argonraver/quadruped-robot-for-smart-agriculture-uofu/README.md

# quadruped-robot-for-smart-agriculture-uofu
Open source quadruped robot for smart agriculture research from the University of Utah.

## Team Members
Austin Neff, Kevin Nelson, Jordan Raver, Ben Siesser, Sam Spencer, and Yang Yang

## Project Advisors
Shad Roundy and Kam Leang
