argonraver/quadruped-robot-for-smart-agriculture-uofu/Quadruped Robot for Smart Agriculture/Spring Assignments/Project Milestones Document.docx

1. Project Problem Statement & Scope

Problem statement: The objective of the project is to construct a quadruped robot. The Open Dynamic Robot Initiative will be used as guidance. The robot is intended as a cheaper and more open alternative for robot smart agriculture than what is currently available in professors Roundy and Leang’s laboratories.

The only change is that field navigation was changed from “Must be part of scope” to “Optional scope”

Must be part of scope | Optional Scope | Not included in Scope
1. Runs on ROS 2 2. Use ROS 2 Humble 3. Autonomous; no tether 4. On-board Power System that can run for minimum 30 minutes 5. Modify design to enclose electronics –weathertight 6. Easily storable, carryable (handles, box) 7. Utah red colors | 1. Can navigate to four points in a field. 2. Rebuild chassis with stronger materials during second semester (fiberglass infused ABS) | - Additional actuators - Additional sensors - Efficient walking - Manipulators - Radio beacon triangulation - 12 degree of freedom

2. ME EN 4010 Milestones & Tasks

ME EN 4010 Assignment | Milestone(s) | Metric of success | Measurement | Tasks
Design Review 1 (01/27-01/31) | 1. Foundational control code complete and to command ODrive controller boards while being able to receive information from the IMU | Command capability, sensor reading | <200 ms latency while switching modes and updating and filtering IMU readings | Write the following nodes: - Central command node - Primitive loader - Leg control and IK node - IMU node - Filter node - Node to convert primitive to ramp, offset according to IMU
| 2. Majority of robot body complete including eight control board mounting brackets, two battery mounts, and printed leg components for eight legs | Proportion of components mounted | >90% (eight control board mounting brackets, two battery mounts, OrangePi and power distribution board mounts, all components added to mounts and wired up) | - Print all body components - Assemble body - Mount electronics - Wire everything up
| 3. Two leg segments complete and mounted for initial single leg testing | Number of actuator modules built | At least 2 modules (1 leg) | - Print legs in CFPLA - Assemble actuators - Mount actuators as they are completed
Midterm Prototype & Report (02/21) | 4. All four legs mounted and actuated for coordinated movement | Number of actuator modules built | All 8 modules | - Print remaining legs - Finish assembly - Mount remaining actuators
| 5. Body complete and enclosed with a lid printed in CF-PLA | Proportion of components mounted | 100% (All components from before plus legs mounted and additional “lid” and handle finished and attached) | - Complete any remaining tasks from above - Add any necessary sensors for navigation
| 6. Basic Motion achieved, able to coordinate all leg segments to make the robot stand up, turn, walk consistently in lab environment(Not necessarily including speed variance, rough terrain) | Number of directions of motion available via primitives | 6 (Left Turn, Right Turn, Forwards, Backwards, Rise, Crouch) | Create primitives to: - Walk forward or backward - Turn left or right - Stand up - Lay down - battery test (how far can it go?)
Design Review 2 (03/17-03/21) | 7. Fully autonomous; no tether. Robot is able to run off of battery power and be controlled via a SSH network | No physical connections necessary to direct and move | Zero physical connections without loss of functionality | - Build the power system to be self sufficient - Implement wireless command system
| 8. On-board Power System can run for minimum 30 minutes | Runtime in general walking scenario | >30 minutes | - Develop an endurance test - Run the test, log results - Test additional battery sizes if results are disagreeable
| 9. Full motion of robot, able to walk distances consistently without issues in varied environments including outdoor areas | Variable speed, rough terrain capability | Variable speed: Number of alternate sets of walking primitives that enable alternate speeds. Target of at least two. Rough Terrain Capability: Test maximum grade robot can walk up (at least 30 degrees), largest offset between legs it can pass over without toppling (>4 inches), largest radius object it can step on edge of without slipping (>1 inch) | - Add IMU modification to target joint angles - Create additional primitives for faster or slower gaits
| 10. Basic Navigation to beacons using GPS or towards a radio frequency (optional scope) | Can navigate to beacons with wireless (radio) detection. Basic navigation entails a simple depth first search algorithm to move across discretized field locations until signal peaks for goal. | Navigation to at least one beacon during runtime. | - Implement necessary additional sensors - Write a simple seeker node
Final Report (04/14) | 11. Optimize Navigation to path-find to four beacons in different locations (optional scope) | Can reach target number of beacons during runtime. Optimized navigation depends on a higher level dynamic motion planning algorithm. | Can reach all four beacons and return within runtime | - Implement advanced navigation algorithm - Expand seeker node to accept multiple targets

3. Team Member Roles

Austin- I will be helping Ben with the 3D printing and assembly. Along with that I will be leading the charge on documents, assignments, and slides. I will be very involved in testing and debugging. I will also be available to help the coding team and power system in any way I can.

Ben- I will be leading 3D printing and assembly along with being lead 3D modeler. I will be very involved in testing the design structurally, especially fixing the mechanical design if it breaks or needs to be fixed. I will also help the power system team in any way I can.

Sam - I also will be working on the layout and mounting hardware for the internal components. I will also be working on the power system. This will include creating cables and solving cable management problems, as well as implementing a power distribution board which supplies the required current and various voltages.

Kevin - I am the lead on both design and implementation of our code. I will be coming up with the general arrangement of nodes to control our robot, refining them with the rest of the group, then actually implementing them. For any nodes where performance is a concern, they will need to be implemented in C++ which is my purview. I will also work to make sure that all components integrate together effectively, and that no robot components clash with each other’s functionality.

Jordan - I am the second main programmer on the team and will help design and implement our code. I’ll be helping to write and organize nodes, primitives, and control algorithms for our robot and will also be focusing on the kinematics of our robot to implement into our control algorithms. I will also be helping out with the assembly as much as I can when I’m not working on the code.

Yang - I am helping with code and building as needed. I’m looking into and helping with programming auxiliary functions, like sensors. I’m primarily responsible for keeping track of the bill of materials, budget, and submitting buy orders.

4. Final Deliverables

- Final assembled robot
- Email\flash drive with all code and 3d printed part models
- ME EN 4010 Final Report, poster presentation files
- Documentation for setup and code use
- Bill of Materials
- Videos of robot working
- Any spare or extra parts and materials

5. Concerns, Challenges, Special Needs, etc.

Our biggest challenge for the semester is to make the walking software. Making good primitives is going to take a lot of time.

6. Advisor Approval

This document must be approved by your faculty advisor and/or project sponsor. You may upload a PDF copy of an email from your advisor or sponsor saying that they have read and approved the Project Milestones document. Alternatively, you may have them sign a digital copy of the document.

Engineering Design II – ME EN 4010 Spring 2025
