argonraver/quadruped-robot-for-smart-agriculture-uofu/Quadruped Robot for Smart Agriculture/Demo.pptx

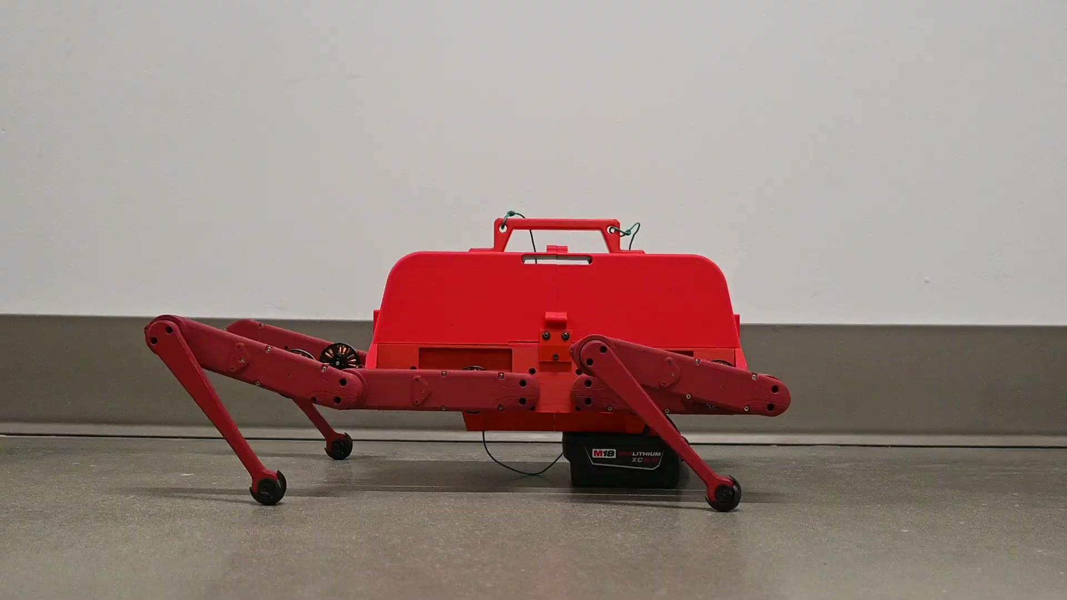
[picture p63: figure]

## Slide 2

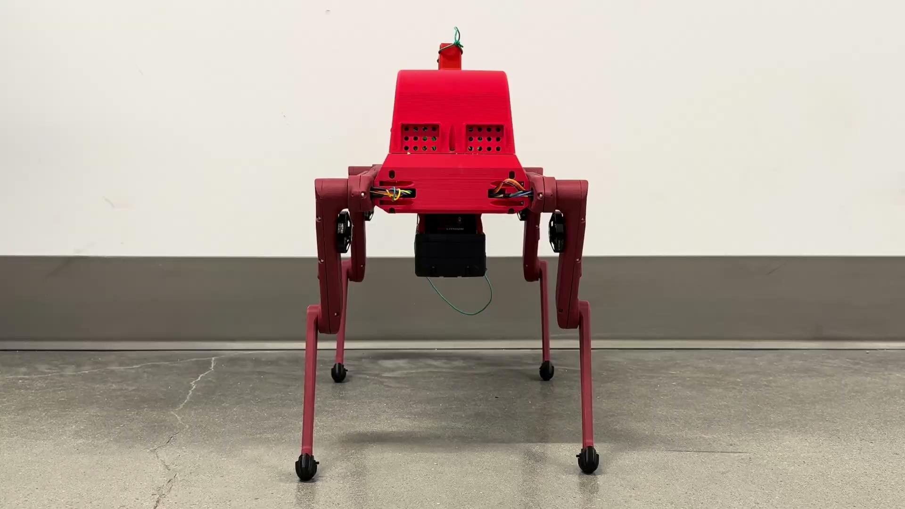
[picture p64: figure]

## Slide 3

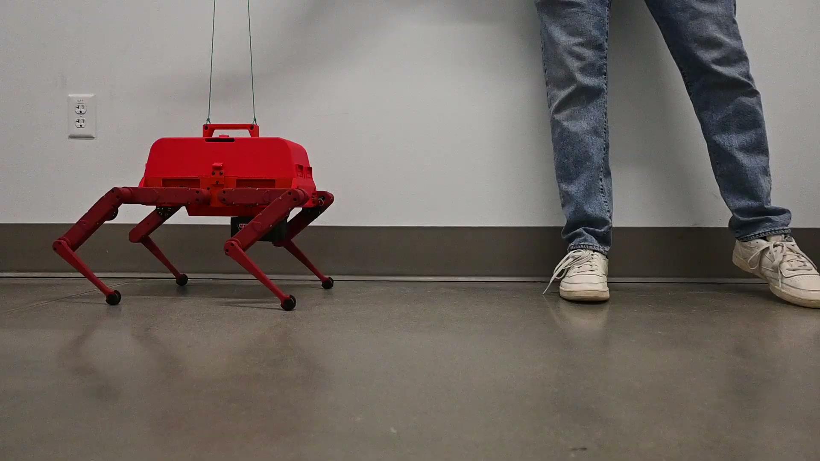
[picture p65: figure]

## Slide 4

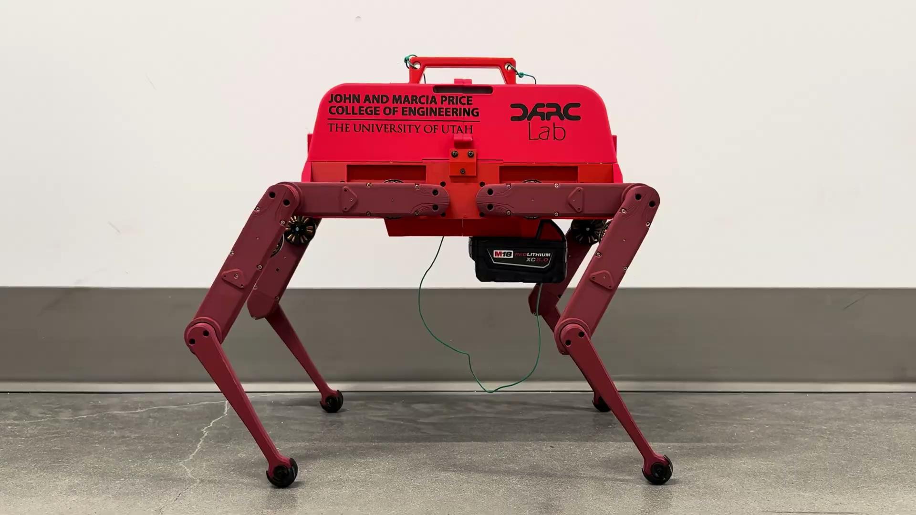
[picture p66: figure]

## Slide 5

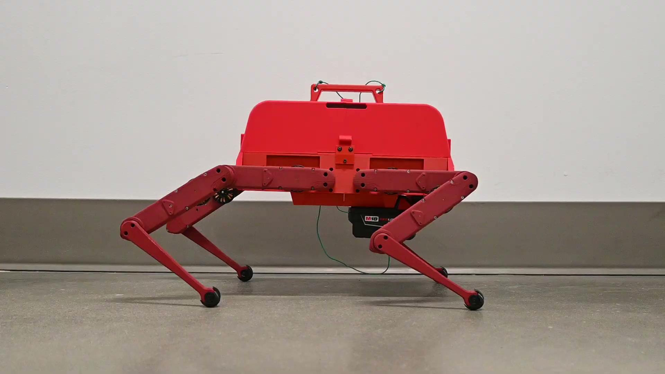
[picture p67: figure]
