argonraver/quadruped-robot-for-smart-agriculture-uofu/Pictures and Videos/DSC_0645.JPG

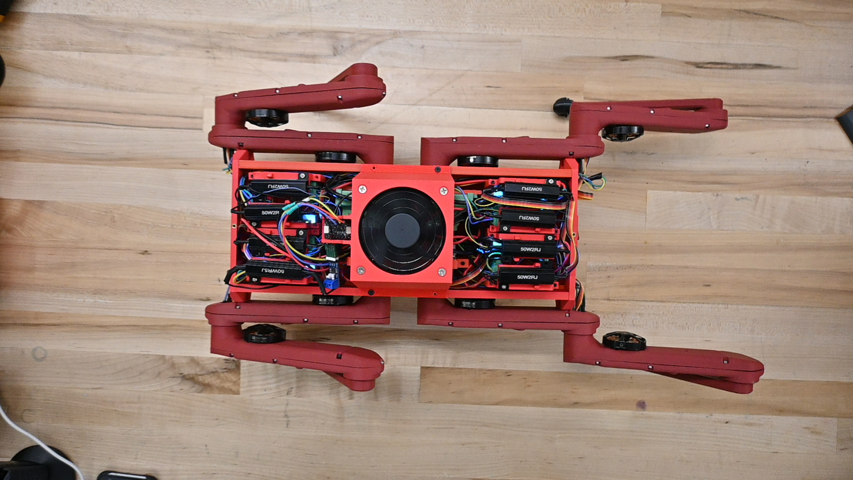
Pictures and Videos/DSC_0645.JPG
