argonraver/quadruped-robot-for-smart-agriculture-uofu/Quadruped Robot for Smart Agriculture/Documentation/ODrive Arrangement.jpg

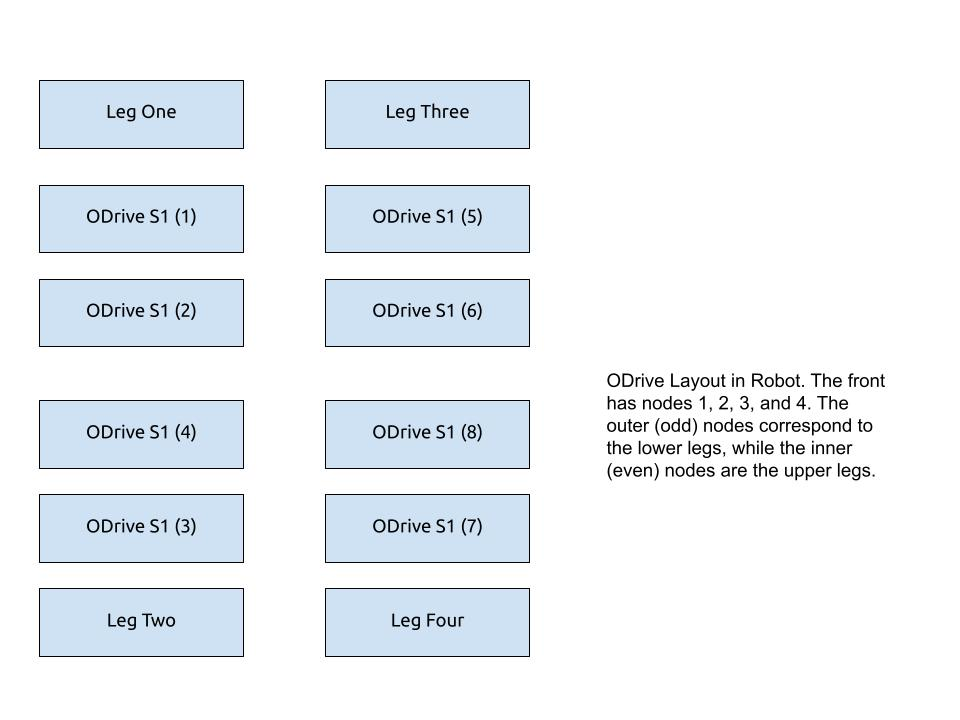
Quadruped Robot for Smart Agriculture/Documentation/ODrive Arrangement.jpg
