argonraver/quadruped-robot-for-smart-agriculture-uofu/Quadruped Robot for Smart Agriculture/Fall Assignments/Sketches/Charging Case.jpg

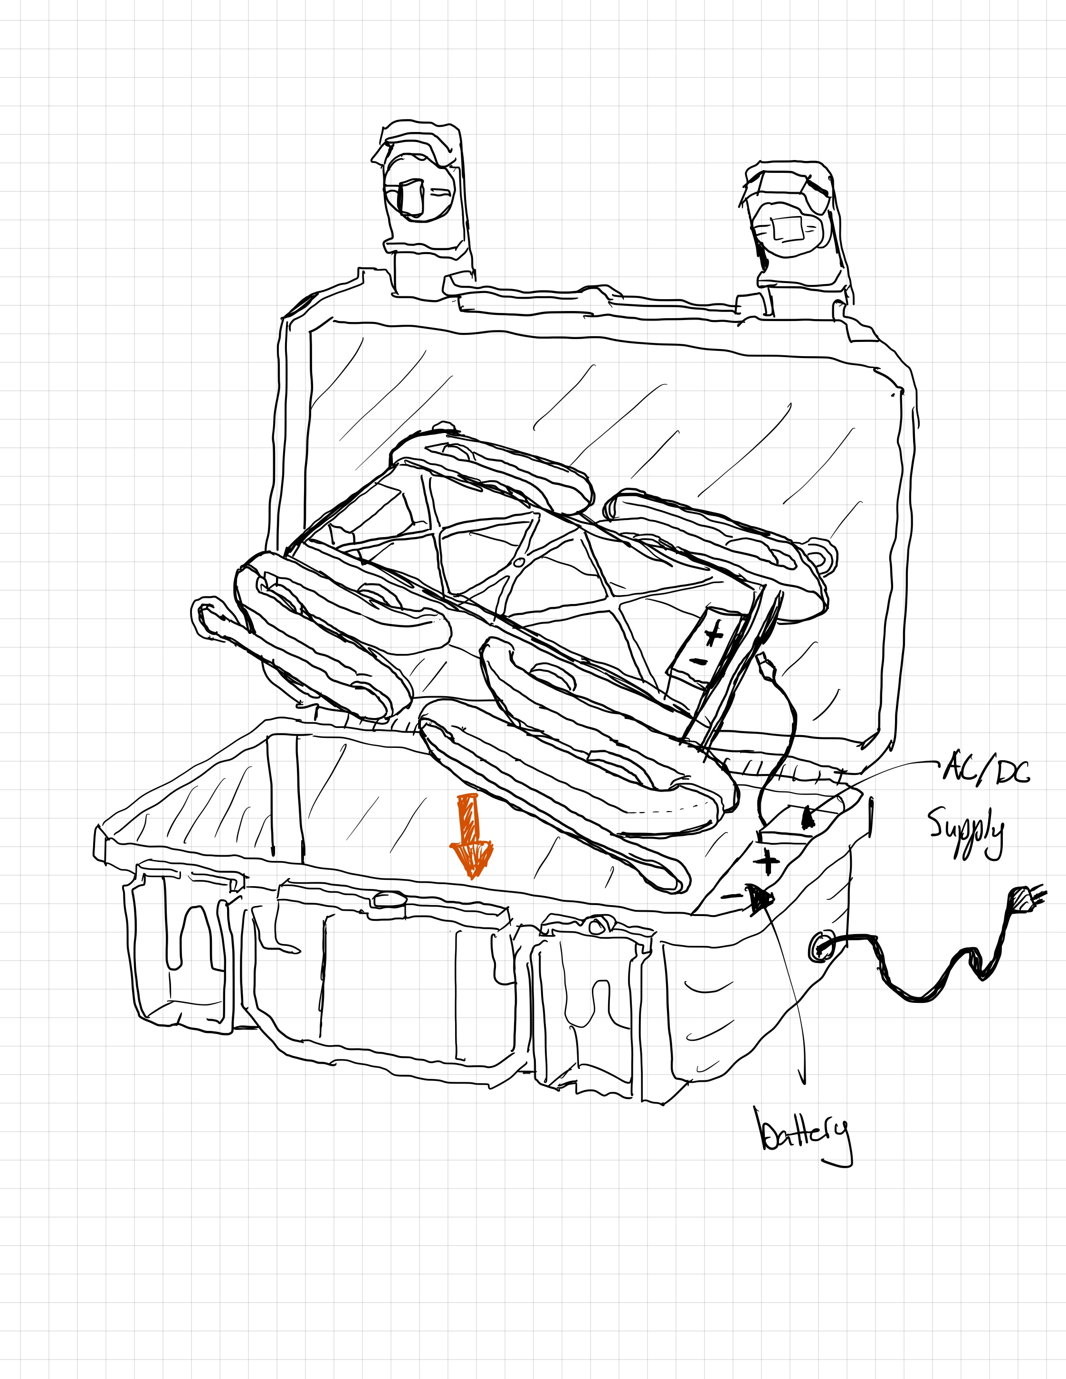
Quadruped Robot for Smart Agriculture/Fall Assignments/Sketches/Charging Case.jpg
