argonraver/quadruped-robot-for-smart-agriculture-uofu/Quadruped Robot for Smart Agriculture/Fall Assignments/Sketches/Dual Purpose Lid Case.jpg

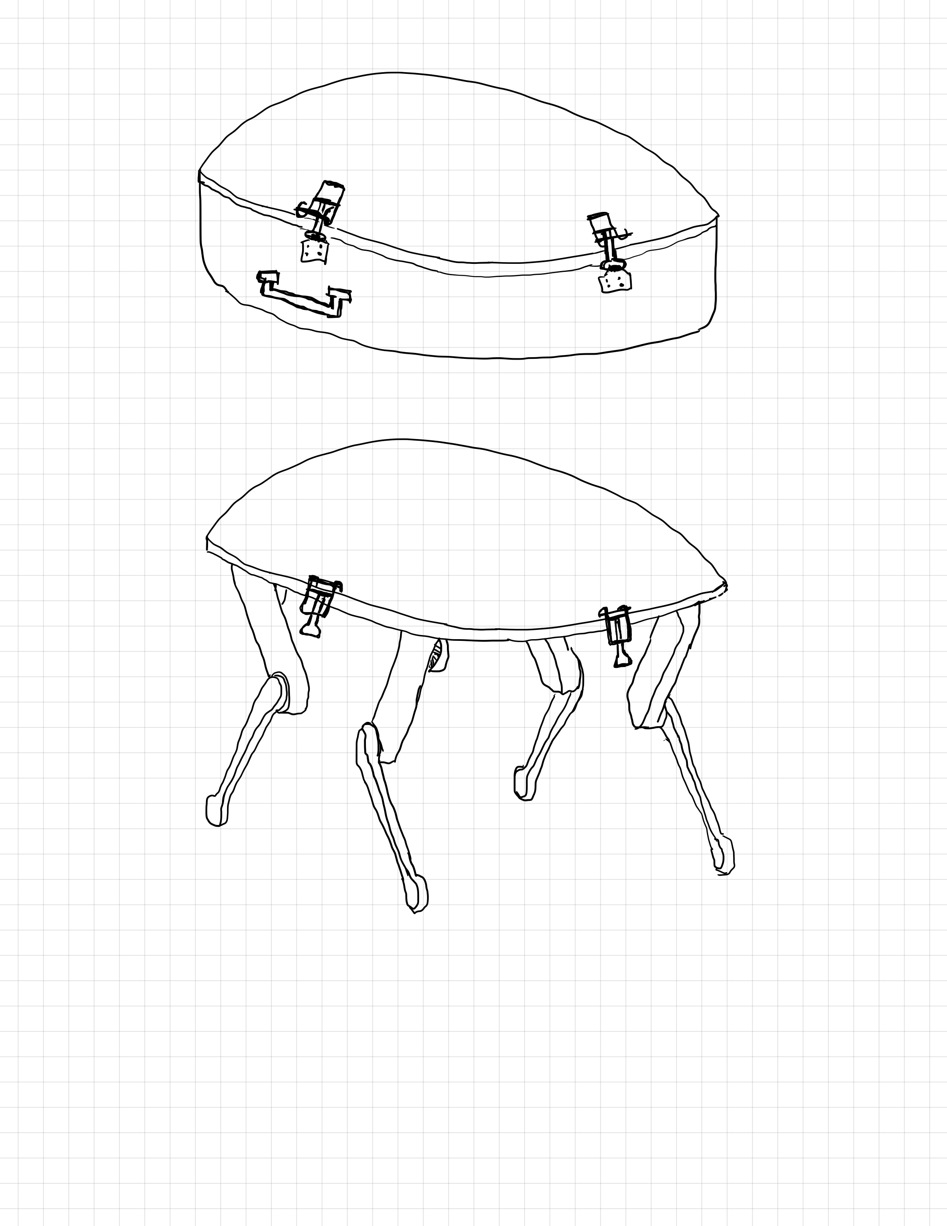
Quadruped Robot for Smart Agriculture/Fall Assignments/Sketches/Dual Purpose Lid Case.jpg
