argonraver/quadruped-robot-for-smart-agriculture-uofu/Quadruped Robot for Smart Agriculture/Fall Assignments/Sketches/Gel Coated.jpg

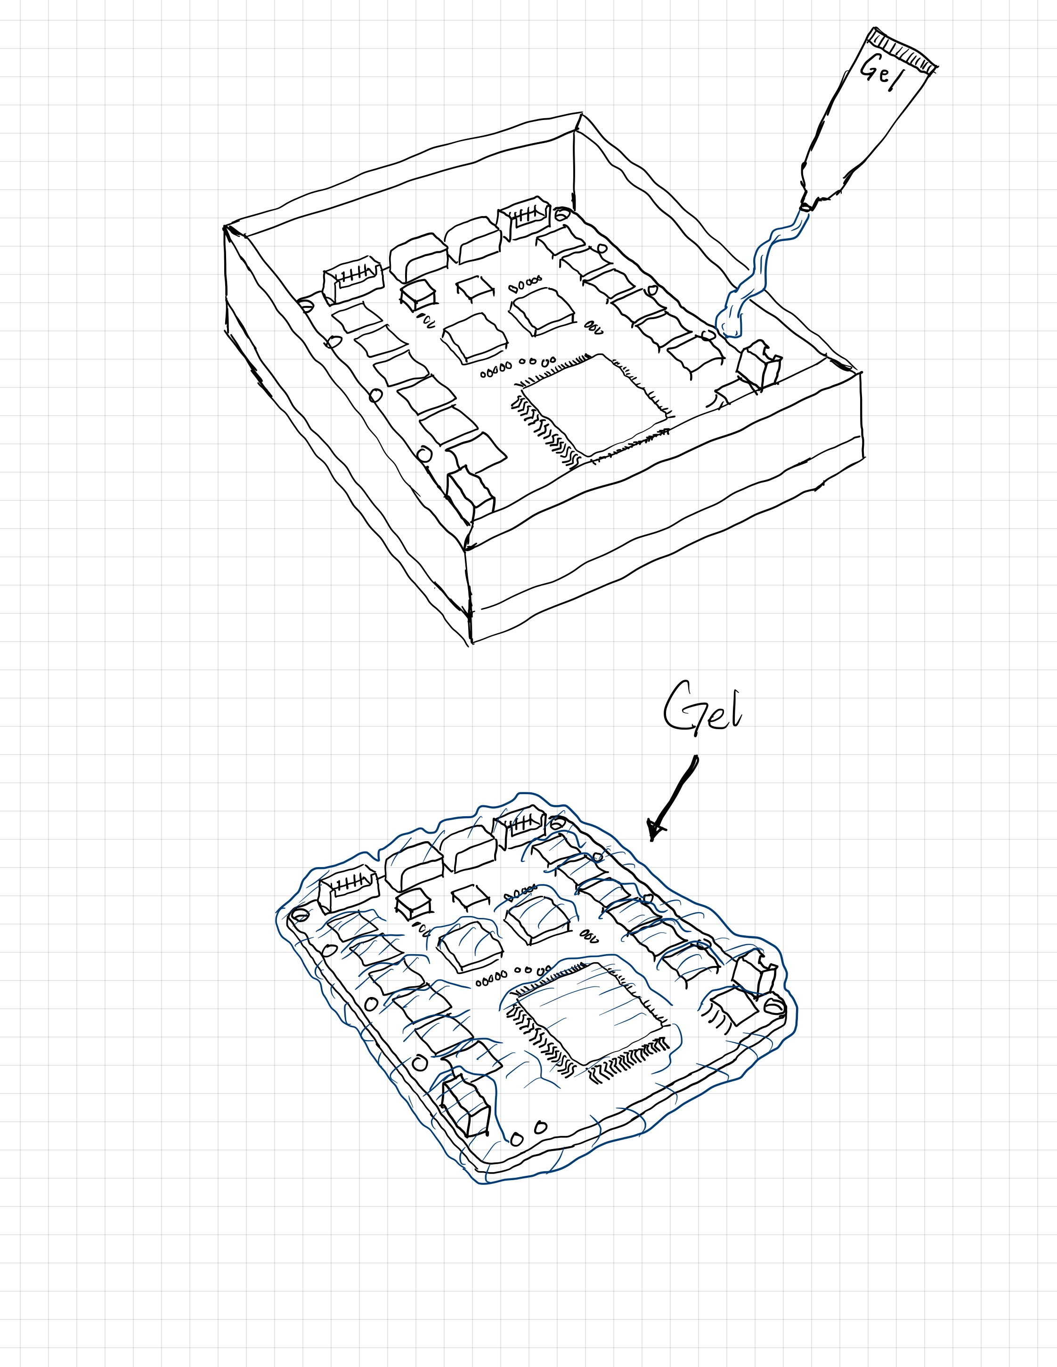
Quadruped Robot for Smart Agriculture/Fall Assignments/Sketches/Gel Coated.jpg
