argonraver/quadruped-robot-for-smart-agriculture-uofu/Quadruped Robot for Smart Agriculture/Fall Assignments/Sketches/Hard Cover.jpg

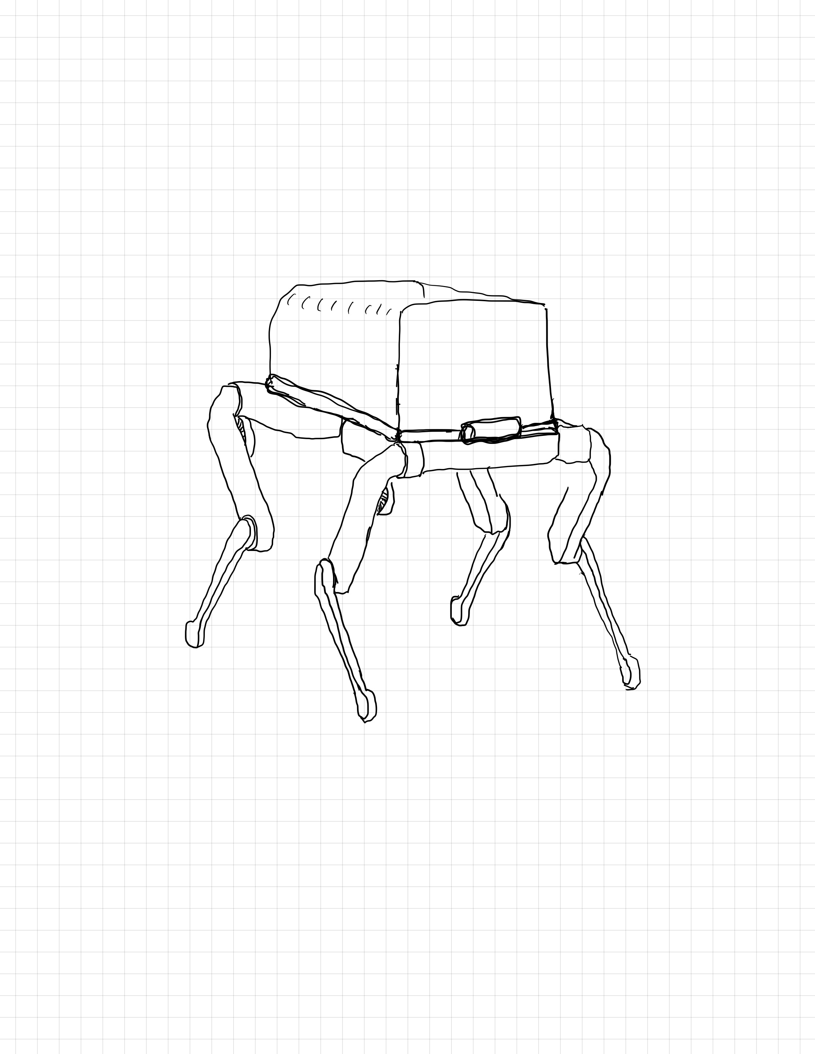
Quadruped Robot for Smart Agriculture/Fall Assignments/Sketches/Hard Cover.jpg
