argonraver/quadruped-robot-for-smart-agriculture-uofu/Quadruped Robot for Smart Agriculture/Fall Assignments/Sketches/Umbrella.jpg

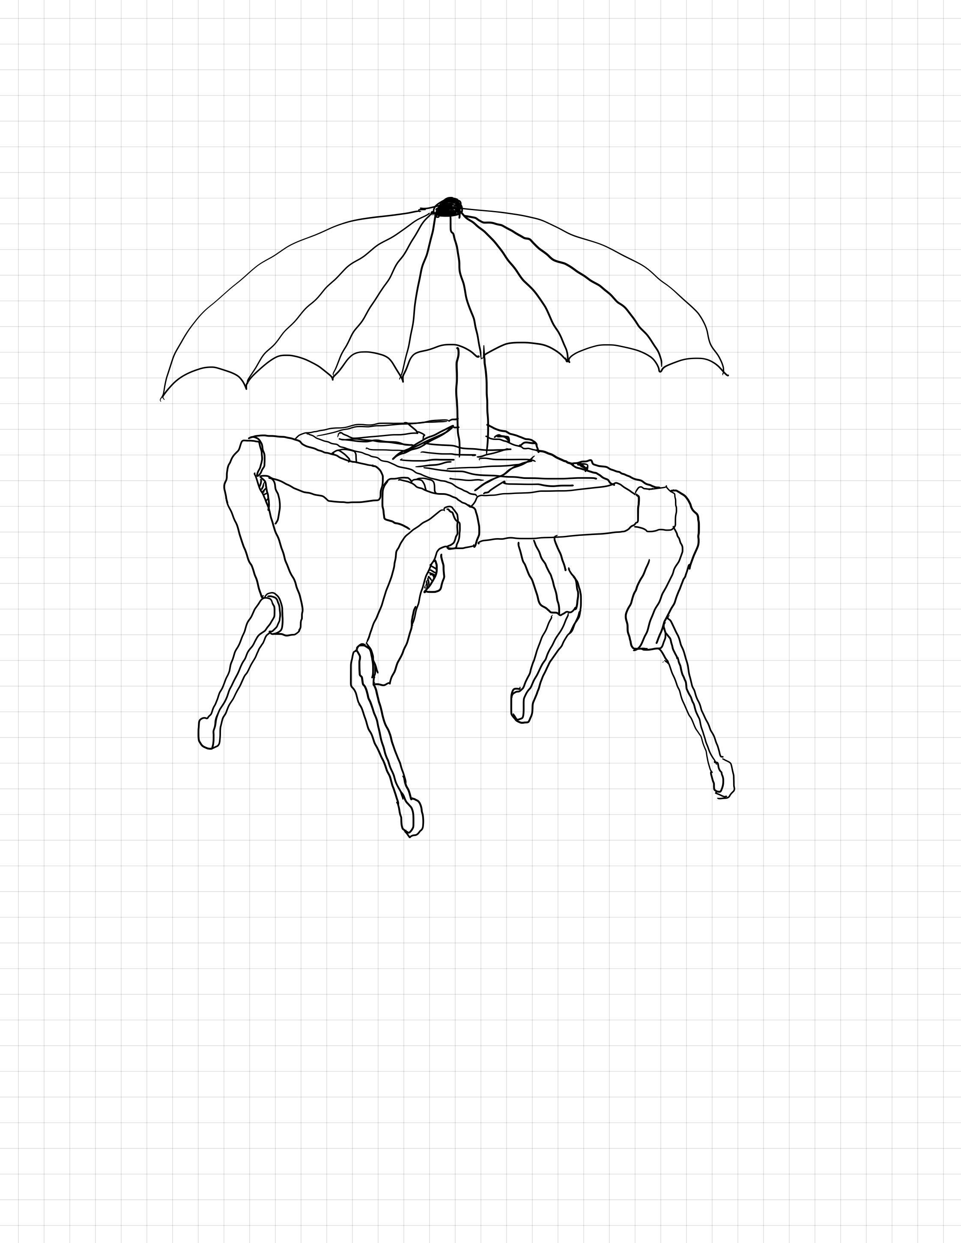
Quadruped Robot for Smart Agriculture/Fall Assignments/Sketches/Umbrella.jpg
