argonraver/quadruped-robot-for-smart-agriculture-uofu/Quadruped Robot for Smart Agriculture/Fall Assignments/Sketches/Wide Feet.jpg

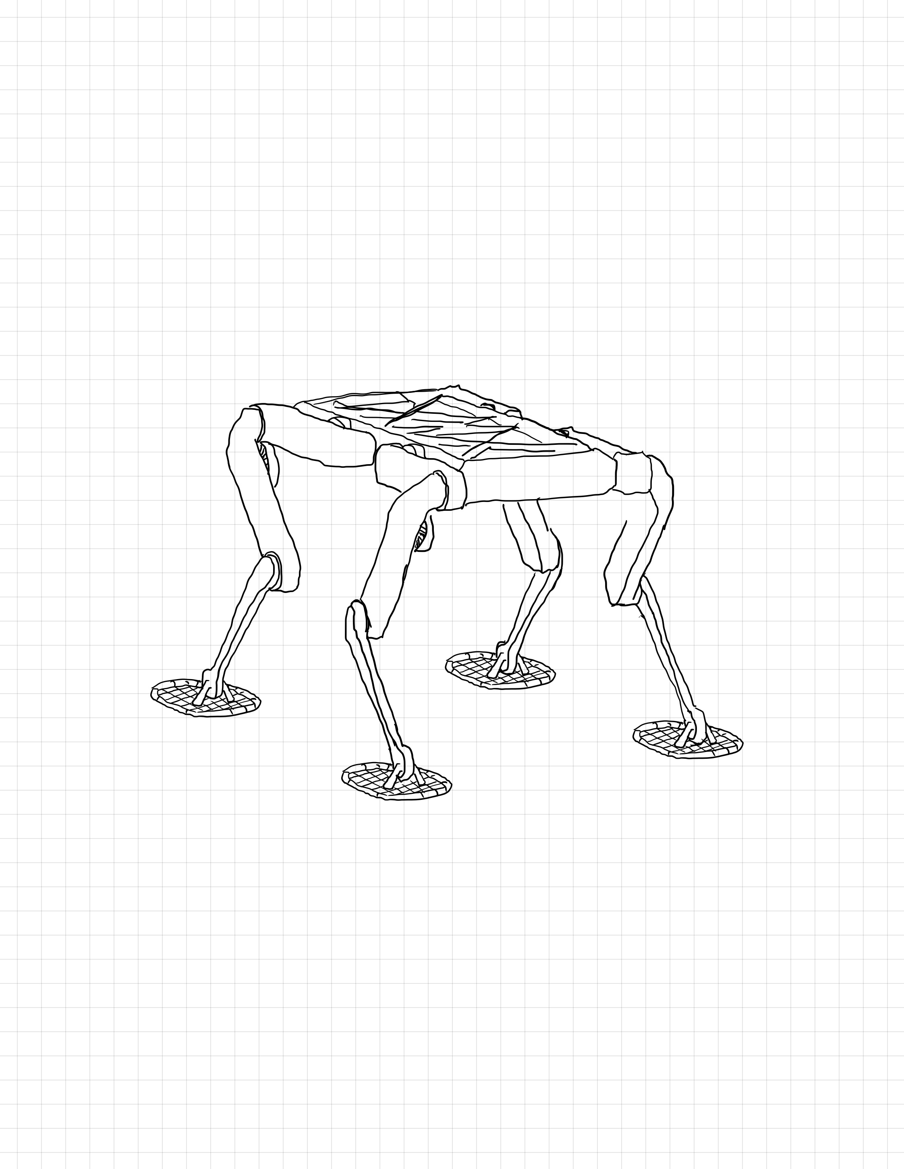
Quadruped Robot for Smart Agriculture/Fall Assignments/Sketches/Wide Feet.jpg
