argonraver/quadruped-robot-for-smart-agriculture-uofu/Quadruped Robot for Smart Agriculture/RobotElectronics Sketch_schem.png

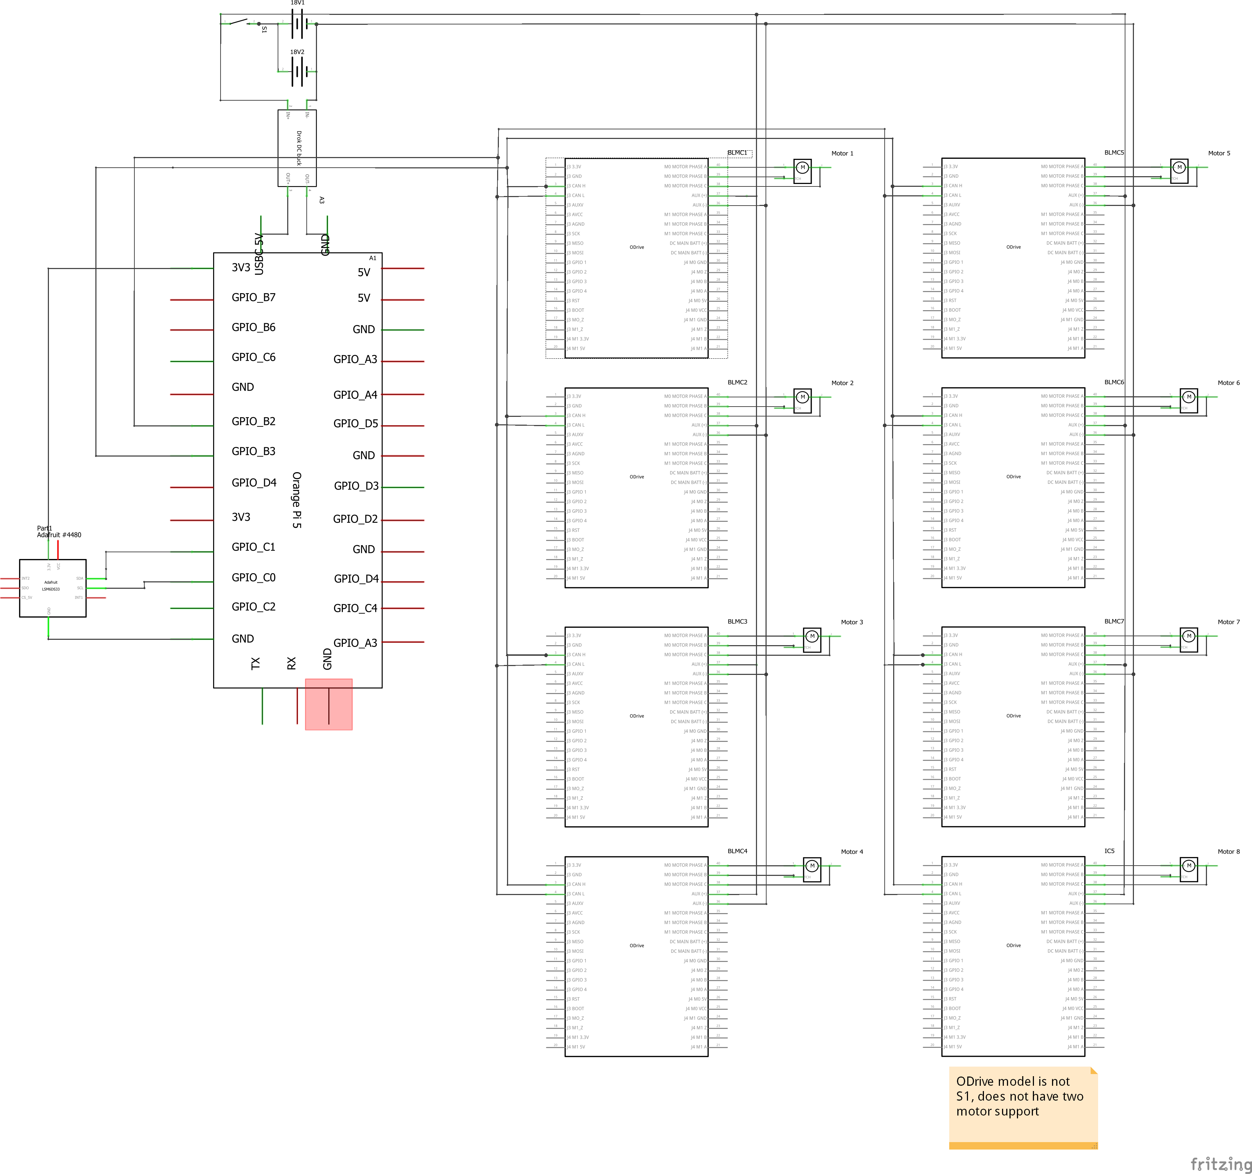
Quadruped Robot for Smart Agriculture/RobotElectronics Sketch_schem.png
