argonraver/quadruped-robot-for-smart-agriculture-uofu/Quadruped Robot for Smart Agriculture/BOM.xlsx

Sheet: Consolidated BOM
Part | Link | Supplier | Quantity | Price Individual Part | Price All Parts | Description | Off the Shelf (Y/N) | Contact Info | Order Placed | Cost Breakdowns | Total Spent
M3 x 5 SS (50 pcs) | https://www.mcmaster.com/products/screws/flat-head-screws~/flat-head-profile~standard/system-of-measurement~metric/metric-316-stainless-steel-hex-drive-flat-h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 | mcmaster | 1 | $5.09 | $5.09 | M3 x 5mm 316 Stainless | Y | N/A | x | Subtotal | $4431.90
M3 Screw and Nut Assortment | https://www.amazon.com/dp/B0B51BFSWZ?s=hi&sp_csd=d2lkZ2V0TmFtZT1zcF9kZXRhaWw | Amazon | 1 | $7.99 | $7.99 | Kadrick Small Metric Screws Suitable for 3D Printer DIY, 400 Pcs M3 Screw and Nut Assortment Hex Socket Head Cap, 12.9 Grade Alloy Steel,Black Zinc Plated | Y | N/A | x | $4180.94
M3 x 4.5 Helicoil (10 pcs) | https://www.mcmaster.com/products/threaded-inserts/threaded-inserts-2~/stainless-steel-helical-inserts-9/ | mcmaster | 3 | $8.98 | $26.94 | Stainless Steel Helical Insert, M3 x 0.5 Thread Size, 4.5 mm Long | Y | N/A | x
M3 x 6 Helicoil (10 pcs) | https://www.mcmaster.com/products/threaded-inserts/threaded-inserts-2~/stainless-steel-helical-inserts-9/ | mcmaster | 3 | $11.35 | $34.05 | Stainless Steel Helical Insert, M3 x 0.5 Thread Size, 6 mm Long | Y | N/A | x
Brushless Motor (2pk) | https://shop.tmotor.com/products/mn2806-1 | Lab | 4 | $0.00 | $0.00 | TMOTOR MN4004 300kv AntiGravity UAV Brushless Motor | Y | N/A | x
Bearing Output Shaft | https://www.123bearing.com/bearing-housing/deep-groove-bearing/single-row/61705-2rs?gad_source=1 | 123-Bearing | 16 | $5.02 | $92.42 | 32mm x 25mm x 4mm EZO bearing 61705 2RS VA | Y | N/A | x
Bearing Motor Shaft and Center Shaft | https://www.123bearing.com/bearing-housing/deep-groove-bearing/single-row/mr84-ezo?gad_source=1 | 123-Bearing | 24 | $8.03 | $166.56 | 8mm x 4mm x 2mm EZO bearing MR84 VA | Y | N/A | x
Bearing Timing Belt Tensioner | https://www.123bearing.com/bearing-housing/deep-groove-bearing/single-row/683-zz-ezo?gad_source=1 | 123-Bearing | 16 | $6.24 | $112.64 | 7mm x 3mm x 3mm EZO bearing 683 2Z VA | Y` | N/A | x
Timing belt first stage | https://www.beltingonline.com/at3-gen-iii-synchroflex-timing-belts-4593 | Belting Online | 8 | $5.96 | $47.71 | Timing Belt Conti Synchroflex AT3 GEN III width: 4mm / length: 150mm / 50 teeth | Y | N/A | x
Timing belt second stage | https://www.beltingonline.com/at3-gen-iii-synchroflex-timing-belts-4593 | Belting Online | 8 | $8.94 | $71.53 | Timing Belt Conti Synchroflex AT3 GEN III width: 6mm / length: 201mm / 67 teeth | Y | N/A | x
Encoder Kits | https://github.com/open-dynamic-robot-initiative/open_robot_actuator_hardware/blob/master/mechanics/general/details/20210407_ODRI-KIT-new.pdf | PWB | 8 | $155.72 | 1245.77 | ODRI Encoder Kit v1.0 #109381 | N | info@pwb-encoders.com | x
M3 x 16mm Plastic Screws (20 pcs) | https://www.amazon.com/uxcell-Plastic-Phillips-Machine-Washers/dp/B0B7RGWSQQ?th=1 | Amazon | 1 | $8.89 | $8.89 | M3 x 16mm Plastic Phillips Machine Screws with Nuts and Flat Washers | Y | N/A | x
20 AWG Cu Wire (6 color, 50 ft each) | https://www.amazon.com/NAOEVO-Silicone-Electrical-Breadboard-Automotive/dp/B0CML8MQD5 | Amazon | 1 | $27.99 | $27.99 | NAOEVO 20 Gauge Wire 300ft, 20 AWG Silicone Wire 50ft Each Spool, 6 Colors Flexible Tinned Copper Wire Electrical Wire | Y | N/A | x
26 AWG Cu Wire (6 color, 50 ft each) | https://www.amazon.com/dp/B089CSCY8S/ref=twister_B0DDXRJX1W?_encoding=UTF8&th=1 | Amazon | 1 | $24.49 | $24.49 | Fermerry 26 AWG Stranded Wire Spool 50ft Each 6 Colors | Y | N/A | x
18 AWG Cu Wire (2 color, 25 ft) | https://www.amazon.com/flexible-Electrical-Extension-Stranded-Automotive/dp/B0D12T94T2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 | Amazon | 1 | $9.50 | $9.50 | Electrical wire 25FT Black and 25FT Red Extension Cable 18AWG | Y | N/A | x
Banana Plugs Connector 2mm (30 pcs) | https://www.amazon.com/dp/B0CPWGKM4Z?s=aht&sp_csd=d2lkZ2V0TmFtZT1zcF9kZXRhaWxfdGhlbWF0aWM | Amazon | 1 | $10.49 | $10.49 | MECCANIXITY 30 Pairs Banana Plugs Connector 2mm Male Female Banana Plug for Speaker Wire RC Battery | Y | N/A | x
Wire Splicer (2, 3, 5 Way) Kit | https://www.amazon.com/GKEEMARS-Compact-Splicing-Connectors-Circuit/dp/B09VSF5TV2 | Amazon | 1 | $14.98 | $14.98 | GKEEMARS 26Pcs Compact Splicing Connectors Wire Connectors Kit 2, 3 and 5 Circuit Inline Splices 24-12 AWG (Grey) | Y | N/A | x
Amass XT30 Connector Male Female | https://www.amazon.com/10Pairs-Upgrade-Connector-Female-Battery/dp/B08P5HVMYT?s=hi | Amazon | 1 | $8.58 | $8.59 | 10Pairs Amass XT30 Connector Male Female XT30U Bullet Plug Heat Shrink for Battery ESC Charger Lead | Y | N/A | x
Ribbon wire 1.27mm pitch | https://www.amazon.com/dp/B07FMCCYBM?s=hi&sp_csd=d2lkZ2V0TmFtZT1zcF9kZXRhaWxfdGhlbWF0aWM | Amazon | 1 | $13.99 | $13.99 | uxcell Flat Ribbon Cable 26P Rainbow IDC Wire 1.27mm Pitch 3 Meters Long | Y | N/A | x
4mm Banana Plug (female adapter) | https://www.amazon.com/Insulated-Safety-Shrouded-Female-Connector/dp/B07KKJQ1Z1 | Amazon | 1 | $9.90 | $9.90 | 10Pcs Brass Insulated Safety Shrouded 4mm Female Banana Plug Jack Socket Solder Cable Connector | Y | N/A | x
4mm Banana Plug (male adapter) | https://www.amazon.com/Current-Stackable-Connector-Speaker-Adapter/dp/B07GL5BVNH | Amazon | 1 | 9.99 | 9.99 | 10Pcs 32A High Current Screw Type 4mm Banana Plugs Male Stackable Connector Speaker Cable Adapter | Y | N/A | x
Pin Header 2,54 mm pitch | already in lab, can only buy in bulk anyways |  | 1 | 1 | $1.00 |  | Y | N/A | x
12-Bit Ring LEDs (maybe not) | https://www.amazon.com/Stemedu-5050SMD-Individually-Addressable-Raspberry/dp/B0C7CFQXY3 | Amazon | 1 | $8.99 | $8.99 | 12 Bits WS2812 5050SMD RGB LED Ring Full Color LED Lamp Individually Addressable Colorful LED Light for Arduino Raspberry Pi Project (Pack of 2) | Y | N/A | x
Right Angle Pin Header | in our lab already |  |  | $0 |  | Pitch 2.54mm | Y | N/A | x
Orange Pi |  | Amazon | 1 | $127.99 | $127.99 | Master Microcontroller | Y | N/A | x
CF-PLA | https://us.store.bambulab.com/products/pla-cf?variant=41145212076168 | Bambu Labs | 2 | 34.99 | 69.98 | CF-PLA for full reprint | Y | N/A | x
ODrive S1 | https://odriverobotics.com/shop/odrive-s1 | ODrive Robotics | 10 | $149 | $1490 | BLDC Servo Controller | Y | N/A | x
J11 Connector | https://www.digikey.com/en/products/detail/jst-sales-america-inc/PUDP-30V-S/1989468 | Digikey | 12 | $0.65 | $7.80 |  | Y | N/A | x
J11 Crimp Pins | https://www.digikey.com/en/products/detail/jst-sales-america-inc./SPUD-002T-P0.5/1989510?gad_source=1 | Digikey | 450 | $0.032 | $14.328 | SPUD-002T-P0.5 | Y | N/A | x
J16, J17, J1 Pre-crimped connectors | https://www.amazon.com/Pre-Crimped-Connectors-Pixhawk2-Pixracer-Silicone/dp/B07PBHN7TM?hvadid=693418895682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 | Amazon | 1 | $18.99 | $18.99 | Assorted Cables | Y | N/A | x
SanDisk 32GB microSD | https://www.amazon.com/SanDisk-Ultra-UHS-I-Memory-Adapter/dp/B00M55C0NS | Amazon | 1 | $7.85 | $7.85 | Orange Pi 5 Memory | Y | N/A | x
Braking Resistors (5ct) | https://www.amazon.com/Comidox-Aluminum-Housed-Wirewound-Resistor/dp/B077ZMYNBF | Amazon | 2 | $9.99 | $19.98 |  | Y | N/A | x
IMU 6-Axis Board | https://www.adafruit.com/product/4438 | Adafruit | 1 | $11.95 | $11.95 | Accelerometer and Gyroscope | Y | N/A | x
Encoder for Testing | https://www.digikey.com/en/products/detail/broadcom-limited/AEDM-5810-Z12/5357134 | Digikey | 1 | $65.90 | $65.90 | Comperable encoder as from kit | Y | N/A | x
Heat Set Insert tip Tool | https://www.amazon.com/Vertical-Pressing-Machine-Inserts-Printing/dp/B0D22MLFMD/134-3460923-3496503 | Amazon | 1 | $38.99 | $38.99 |  | Y | N/A | x
M2.5x6 Socket Head Screws | https://www.amazon.com/iexcell-Thread-Stainless-Socket-Screws/dp/B0D7S1CM87 | Amazon | 1 | $7.28 | $7.28 |  | Y | N/A | x
M2.5x10 Socket Head Screws | https://www.amazon.com/iexcell-Thread-Socket-Screws-Finish/dp/B0DDXNQ7GT | Amazon | 1 | $6.28 | $6.28 |  | Y | N/A | x
10 Pc 20 mm wheels | https://www.amazon.com/10pcs-Wheels-Rubber-Model-Accessories/dp/B07SDC8BK9 | Amazon | 2 | $6.99 | $13.98 |  | Y | N/A | x
80mm x 80mm x 25mm 24V Fan | https://www.amazon.com/GDSTIME-80mm-25mm-Brushless-Cooling/dp/B00N1Y3T9G | Amazon | 1 | $8.59 | $8.59 |  | Y | N/A | x
Untethering Components
Part | Link | Supplier | Quantity | Price Individual Part | Price All Parts | Description | Off the Shelf (Y/N) | Contact Info | Order Placed
USB-C Buck Converter | https://www.amazon.com/dp/B0CRVW7N2J?peakEvent=4&starsLeft=1&skipTwisterOG=1 | Amazon | 1 | 9.99 | 9.99 |  | Y | N/A | x
Spade Crimp Terminals | https://www.amazon.com/Baomain-Male-Spade-Quick-Splice-Crimp-Terminals-6-3mm-Crimp-Connector-Non-Insulated-Pack-of-100/dp/B01MQ332R6/ | Amazon | 1 | 6.59 | 6.59 |  | Y | N/A | x
Distribution Board | https://www.amazon.com/Channel-Pluggable-Terminal-Distribution-HCDC/dp/B0C72HZPTP?th=1 | Amazon | 2 | 30 | 60 |  | Y | N/A | x
WiFi 4 Dongle | https://www.amazon.com/GenBasic-Wireless-Network-Dongle-Adapter/dp/B0BNFKJPXS | Amazon | 1 | 10 | 10 |  | Y | N/A | x
2-Pack Milwaukee 18V 5Ah | https://www.amazon.com/Milwaukee-48-11-1850-Batteries-48-11-1852-pack/dp/B09NNHN8S8 | Amazon | 1 | 128.98 | 128.98 |  | Y | N/A | x
2 Port Milwaukee Chager | https://www.amazon.com/Milwaukee-48-59-1802-Simultaneous-Rapid-Charger/dp/B084D7B58S | Amazon | 1 | 79 | 79 |  | Y | N/A | x
2-Pack Milwaukee Adapter | https://www.amazon.com/Milwaukee-Converter-Terminals-Connector-Robotics/dp/B0B4F22W7Q | Amazon | 1 | 16.99 | 16.99 | w/ Switch and 20A Fuses | Y | N/A | x
20 4-pin JST wires | https://www.amazon.com/dp/B0C2ZQHZ9T?starsLeft=1 | Amazon | 1 | 9.99 | 9.99 | CAN connection | Y | N/A
Returns |  |  |  |  |  |  |  |  |  | Total Returns
Precision Resistors 7mΩ ±1% | https://www.digikey.com/en/products/detail/bourns-inc/CRE2512-FZ-R007E-3/4900059 | DigiKey | 30 | $0.32 | $9.49 | Current sensing | Y | N/A | x | $110.79
Ethernet Port | https://www.digikey.com/en/products/detail/te-connectivity-amp-connectors/1-1734264-1/5263528?gad_source=1 | DigiKey | 2 | $0.94 | $1.88 | Jack Modular Connector 8p8c (RJ45, Ethernet) 90° Angle (Right) Shielded | Y | N/A | x
Pin Header 8 Position 1.27mm pitch | https://www.digikey.com/en/products/detail/amphenol-cs-fci/20021111-00008T4LF/2209071 | DigiKey | 4 | 0.82 | $3.28 | 4.5 out of 5 stars | Y | N/A | x
5 pin connector | https://www.digikey.com/en/products/detail/hirose-electric-co-ltd/DF13-5S-1-25C/241752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 | Digikey | 40 | $0.17 | $6.72 | CONN RCPT HSG 5POS 1.25MM | Y | N/A | x
Crimp pins | https://www.digikey.com/en/products/detail/hirose-electric-co-ltd/DF13-2630SCF/566967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 | Digikey | 200 | $0.05 | $9.60 | CONN SOCKET 26-30AWG CRIMP TIN | Y | N/A | x
Hirose DF13 Right Angle Header 5 Pin | https://www.digikey.co.uk/en/products/detail/hirose-electric-co-ltd/DF13-5P-1-25DS-25/15997289 | DigiKey | 20 | $0.50 | $10.02 | DF13-5P-1.25DS(25) | Y | N/A | x
USB100v3 JTAG Emulator - BH-USB-100v3D | https://www.digikey.com/en/products/detail/olimex-ltd/TMS320-XDS100-V3/3837620 | Digikey | 1 | $62.86 | $62.86 | USB XDS100 V3 JTAG DEBUGGER | Y | N/A | x
Bosch Inertial Measurement Unit | https://www.digikey.com/en/products/detail/bosch-sensortec/BMI088/8634936 | DigiKey | 1 | $6.94 | $6.94 | Cheap IMU Alternative | Y | N/A | x

Sheet: Predicted and Concurrent Totals
Total Cost Estimate w/ Untethered Power |  |  | Total Ordering Information from Purchasing Request Site |  |  | ~~ODRI Recommended Specs (OLD)~~
w/ Power System Budget of | $1000 | $4733.75 | Vendor | Date | Subtotal | ~~Actuators~~ | ~~#REF!~~
 |  |  | PWB Encoders | 2024-09-21 | $1245.77 | ~~Electrical connectors~~ | ~~#REF!~~
Issues: Dr. Leang recommends ordering extras of components that are likely to break (ODrive & encoder wheels). This will go towards the final $4.7K budget. |  |  | Amazon | 2024-09-28 | $134.74 | ~~Fasteners~~ | ~~#REF!~~
 |  |  | Amazon | 2024-09-30 | $9.99 | ~~Control system~~ | ~~#REF!~~
 |  |  | 123 Bearing | 2024-09-30 | $382.61 | ~~Est. (3 Master, 8 Driver)~~ | ~~$5565.22~~
 |  |  | Belting Online | 2024-09-30 | $202.61 | ~~w/ Battery, Final Chassis~~ | ~~~$6.7K~~
 |  |  | McMaster-Carr | 2024-09-30 | $76.10
 |  |  | Amazon | 2024-09-30 | $7.99
 |  |  | Digikey (Returned) | 2024-09-30 | $14.49
 |  |  | Amazon | 2024-10-10 | $127.99
Milestone |  | Date | ODrive | 2024-10-21 | $156.61
Ordered all structural and electrical connectors |  | 2024-10-21 | Bambu Lab | 2024-10-21 | $69.98
Encoders Arriving |  | 2024-11-12 | Adafruit | 2024-10-21 | $21.33
Everything Ordered (Tethered Robot) |  | 2024-11-12 | Digikey | 2024-10-21 | $93.15
Untethered Power Ordered |  | 2024-12-03 | Amazon | 2024-10-21 | $119.80
 |  |  | Amazon | 2024-11-11 | $19.98
 |  |  | ODrive | 2024-11-11 | 1050.61
 |  |  | Amazon | 2024-12-03 | $315.03
 |  |  | Amazon | 2025-01-26 | $13.56
 |  |  | Amazon | 2025-01-28 | $13.98
 |  |  | Odrive | 2025-02-06 | $337.00
 |  |  | Amazon | 2025-02-06 | $9.99
 |  |  | Amazon | 2025-02-24 | $8.59
 |  |  |  | As of 4/8
 |  |  | Total (+tax&ship): | $4431.90

Sheet: Power Needs
Name | Link | Rated Max Power | Quantity | Peak Current | Voltage |  | Probably not used in this robot but I'll have it here just in case
MN4004 "Antigravity" Brushless Motor kV300 | https://store.tmotor.com/goods.php?id=438 | 216W | 8 | 9A | 24V |  | TI Evaluation Board | https://github.com/open-dynamic-robot-initiative/open_robot_actuator_hardware/blob/master/electronics/ti_electronics/README.md | 24V
ORI Custom Driver Board | https://github.com/open-dynamic-robot-initiative/open_robot_actuator_hardware/blob/master/electronics/micro_driver_electronics/README.md | negligible? | 1 |  | 24V |  | TI Launchpad Board | https://www.ti.com/tool/LAUNCHXL-F28069M
ORI Master Board | https://github.com/open-dynamic-robot-initiative/master-board#master-board | negligible? | 1 |  | 4-60V |  | TI Booster Board | https://www.ti.com/tool/BOOSTXL-DRV8305EVM
Orange Pi 5 | http://www.orangepi.org/html/hardWare/computerAndMicrocontrollers/details/Orange-Pi-5.html | 20W | 1 | 4A | 5V |  | TI Boards can't be used due to interfacing with CAN cables and we can't fit 4 on an Orange Pi
Name | Link | Appx Power Use | Quantity | Current | Voltage | Combined Power | Notes
MN4004 "Antigravity" Brushless Motor kV300 | https://store.tmotor.com/goods.php?id=438 | 90W | 8 | 3.8A | 24V | 720W | ~25% power
ORI Custom Driver Board | https://github.com/open-dynamic-robot-initiative/open_robot_actuator_hardware/blob/master/electronics/micro_driver_electronics/README.md | negligible | 1 |  | 24V
ORI Master Board | https://github.com/open-dynamic-robot-initiative/master-board#master-board | negligible | 1 |  | 4-60V
Orange Pi 5 | http://www.orangepi.org/html/hardWare/computerAndMicrocontrollers/details/Orange-Pi-5.html | 20W | 1 | 4A | 5V | 20W
MicroStrain IMU | https://www.mouser.com/ProductDetail/MicroStrain-by-HBK/3DM-CX5-AHRS?qs=A6eO%252BMLsxmS7srAAhBK2BQ%3D%3D | 0.5W | 1 | 0.1A | 5V | 0.5W
 |  |  |  |  | Total Power | 740.5W
 |  |  |  |  | Predicted Energy | 1.481 kWh
 |  |  |  |  | Energy @ Max | 3.496 kWh
