argonraver/quadruped-robot-for-smart-agriculture-uofu/Quadruped Robot for Smart Agriculture/CAD Files - ME EN 4000/Quadruped 8 DOF Solidworks CAD Files - ME EN 4000/2DOF Leg Solidworks STL Files/hip_module_shell_cover.STL

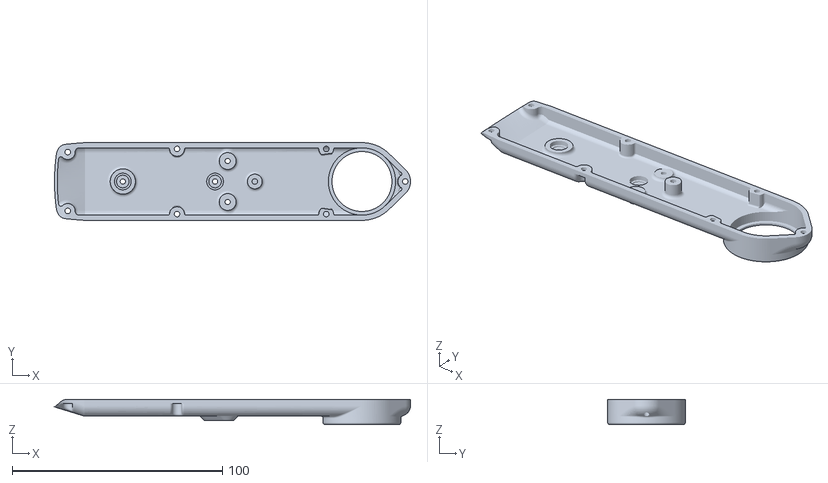
[picture p79: CAD file, 2025-04-24]
Quadruped Robot for Smart Agriculture/CAD Files - ME EN 4000/Quadruped 8 DOF Solidworks CAD Files - ME EN 4000/2DOF Leg Solidworks STL Files/hip_module_shell_cover.STL
169.4 x 37.0 x 12.0
