argonraver/quadruped-robot-for-smart-agriculture-uofu/Quadruped Robot for Smart Agriculture/Documentation/CAD Files/Meshes Documentation/OPi Cap.3mf

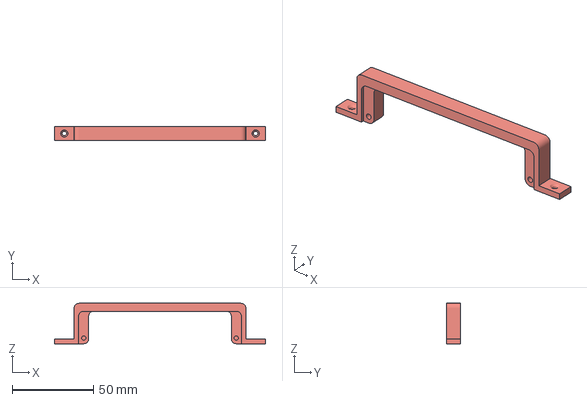
[picture p80: CAD file, 2025-04-24]
Quadruped Robot for Smart Agriculture/Documentation/CAD Files/Meshes Documentation/OPi Cap.3mf
130.2 x 8.50 x 25.0 mm
