argonraver/quadruped-robot-for-smart-agriculture-uofu/Quadruped Robot for Smart Agriculture/CAD Files - ME EN 4000/Leg Parts/Robo_Dog_Foot.SLDPRT

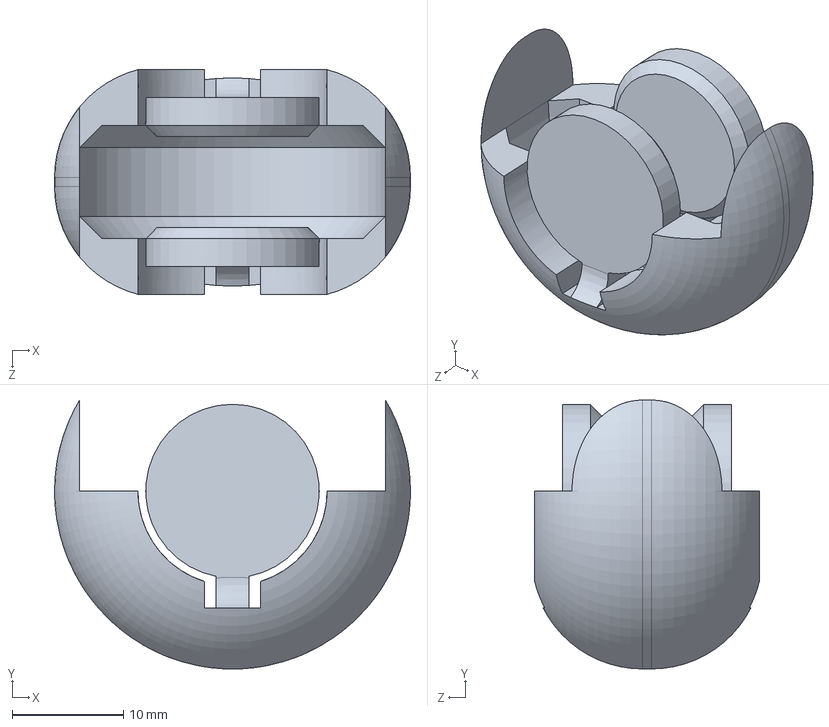
[picture p81: CAD file, 2025-04-24]
Quadruped Robot for Smart Agriculture/CAD Files - ME EN 4000/Leg Parts/Robo_Dog_Foot.SLDPRT
32.0 x 24.2 x 20.2 mm
