argonraver/quadruped-robot-for-smart-agriculture-uofu/Quadruped Robot for Smart Agriculture/CAD Files - ME EN 4000/Quadruped 8 DOF Solidworks CAD Files - ME EN 4000/2DOF Leg Solidworks STL Files/lower_leg_v3.STL

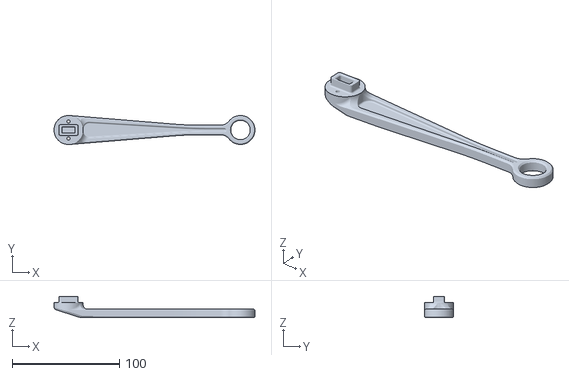
[picture p82: CAD file, 2025-04-24]
Quadruped Robot for Smart Agriculture/CAD Files - ME EN 4000/Quadruped 8 DOF Solidworks CAD Files - ME EN 4000/2DOF Leg Solidworks STL Files/lower_leg_v3.STL
187.0 x 27.0 x 20.0
