argonraver/quadruped-robot-for-smart-agriculture-uofu/Quadruped Robot for Smart Agriculture/Documentation/CAD Files/Meshes Documentation/Quadruped Body_body_structure_front v1_no_hole v1 (1).3mf

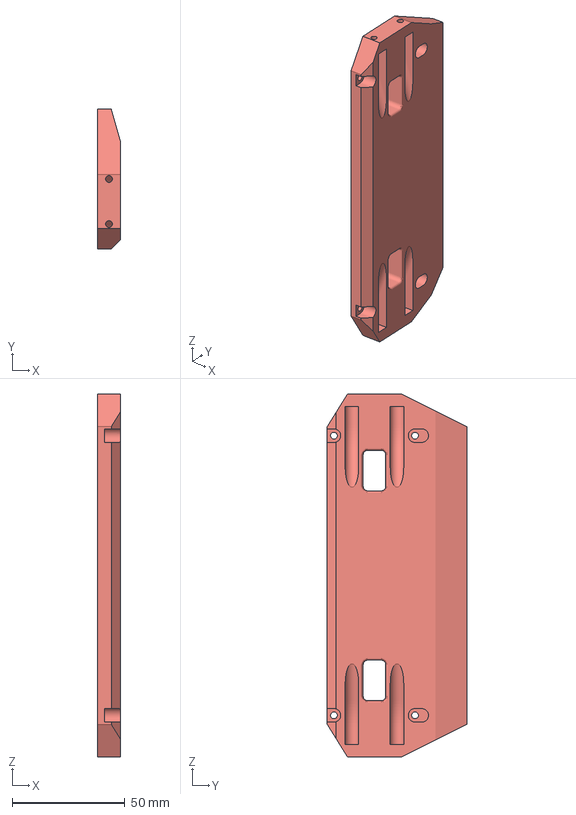
[picture p83: CAD file, 2025-04-24]
Quadruped Robot for Smart Agriculture/Documentation/CAD Files/Meshes Documentation/Quadruped Body_body_structure_front v1_no_hole v1 (1).3mf
10.0 x 62.0 x 161.2 mm
