argonraver/quadruped-robot-for-smart-agriculture-uofu/Quadruped Robot for Smart Agriculture/CAD Files - ME EN 4000/Leg Parts/Easy_Print_Mod_1_upper_leg_module_cover_1.SLDPRT

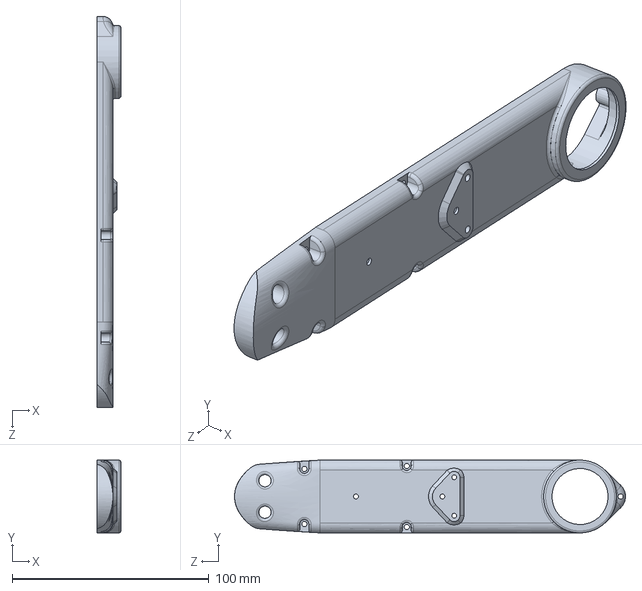
[picture p84: CAD file, 2025-04-24]
Quadruped Robot for Smart Agriculture/CAD Files - ME EN 4000/Leg Parts/Easy_Print_Mod_1_upper_leg_module_cover_1.SLDPRT
12.0 x 37.0 x 198.6 mm
