argonraver/quadruped-robot-for-smart-agriculture-uofu/Quadruped Robot for Smart Agriculture/Documentation/CAD Files/Meshes Documentation/Odrive Cap (inner).3mf

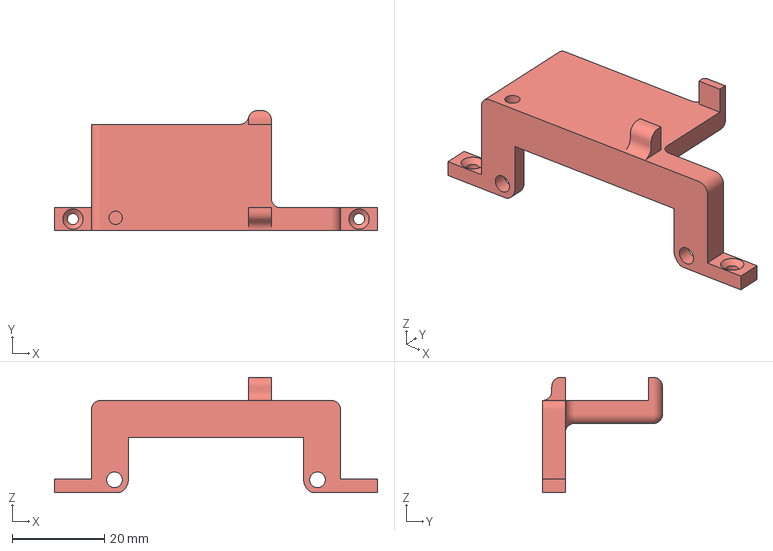
[picture p85: CAD file, 2025-04-24]
Quadruped Robot for Smart Agriculture/Documentation/CAD Files/Meshes Documentation/Odrive Cap (inner).3mf
70.0 x 26.0 x 25.0 mm
