argonraver/quadruped-robot-for-smart-agriculture-uofu/Quadruped Robot for Smart Agriculture/CAD Files - ME EN 4000/Leg Parts/Easy_Print_Mod_1_lower_leg_solid (1).SLDPRT

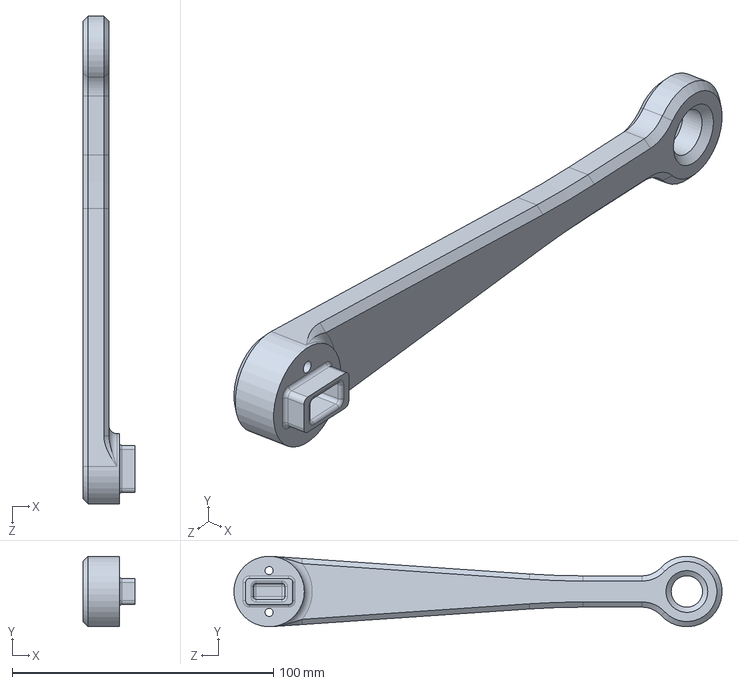
[picture p86: CAD file, 2025-04-24]
Quadruped Robot for Smart Agriculture/CAD Files - ME EN 4000/Leg Parts/Easy_Print_Mod_1_lower_leg_solid (1).SLDPRT
20.0 x 27.0 x 186.9 mm
