argonraver/quadruped-robot-for-smart-agriculture-uofu/Quadruped Robot for Smart Agriculture/Documentation/CAD Files/Meshes Documentation/Body Podium.3mf

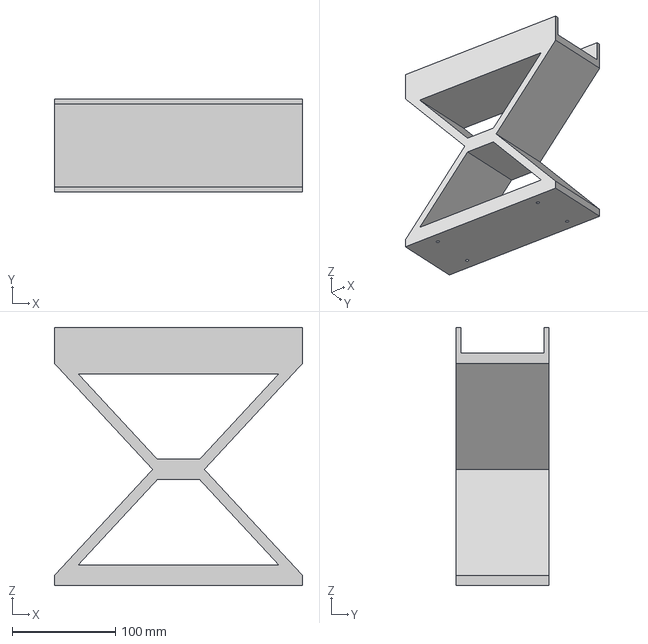
[picture p87: CAD file, 2025-04-24]
Quadruped Robot for Smart Agriculture/Documentation/CAD Files/Meshes Documentation/Body Podium.3mf
240.0 x 90.0 x 250.0 mm
