argonraver/quadruped-robot-for-smart-agriculture-uofu/Quadruped Robot for Smart Agriculture/Documentation/CAD Files/Meshes Documentation/body_structure_front v1.3mf

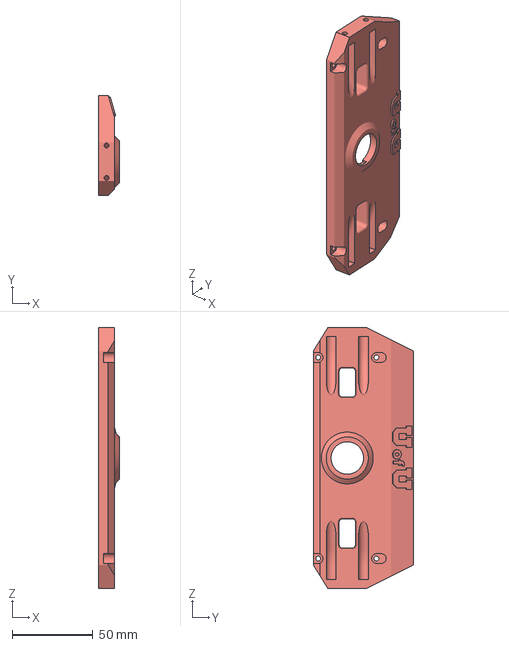
[picture p88: CAD file, 2025-04-24]
Quadruped Robot for Smart Agriculture/Documentation/CAD Files/Meshes Documentation/body_structure_front v1.3mf
13.0 x 62.0 x 161.2 mm
