argonraver/quadruped-robot-for-smart-agriculture-uofu/Quadruped Robot for Smart Agriculture/Documentation/CAD Files/Meshes Documentation/Power and Pi Rack.3mf

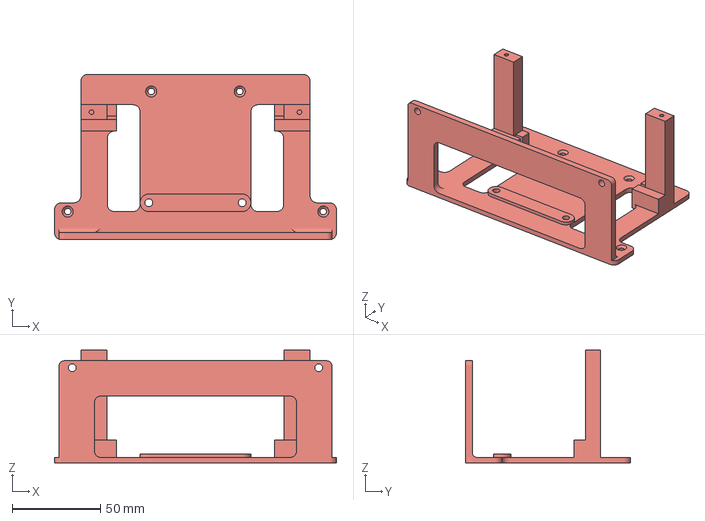
[picture p89: CAD file, 2025-04-24]
Quadruped Robot for Smart Agriculture/Documentation/CAD Files/Meshes Documentation/Power and Pi Rack.3mf
160.2 x 94.0 x 64.0 mm
