argonraver/quadruped-robot-for-smart-agriculture-uofu/Quadruped Robot for Smart Agriculture/Documentation/CAD Files/Meshes Documentation/body_structure_side v1.3mf

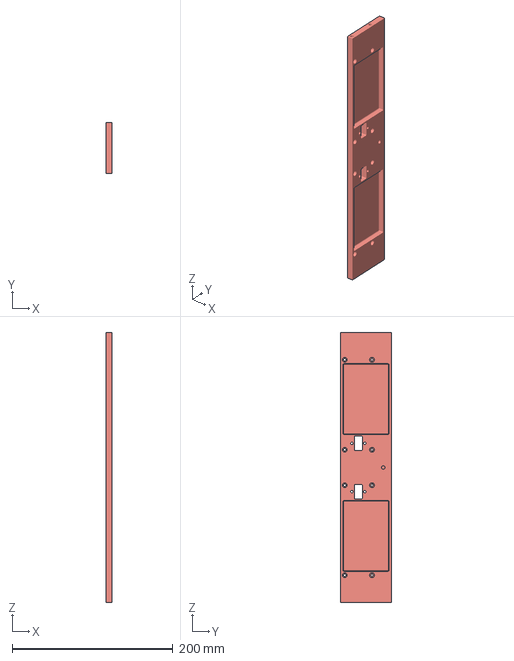
[picture p94: CAD file, 2025-04-24]
Quadruped Robot for Smart Agriculture/Documentation/CAD Files/Meshes Documentation/body_structure_side v1.3mf
8.00 x 63.0 x 335.7 mm
