argonraver/quadruped-robot-for-smart-agriculture-uofu/Quadruped Robot for Smart Agriculture/Documentation/CAD Files/Meshes Documentation/Fan_IMU Mount.3mf

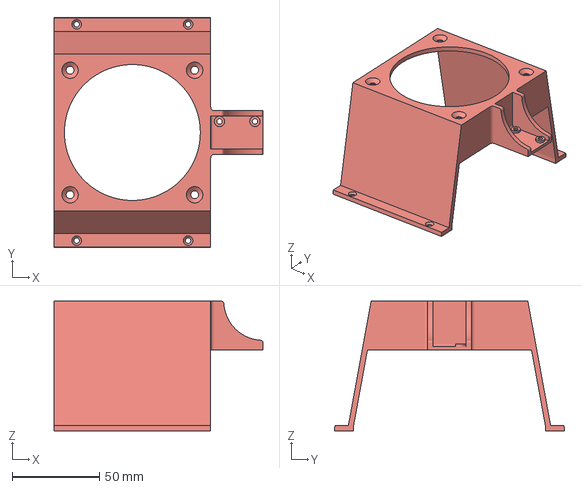
[picture p98: CAD file, 2025-04-24]
Quadruped Robot for Smart Agriculture/Documentation/CAD Files/Meshes Documentation/Fan_IMU Mount.3mf
120.0 x 132.2 x 74.5 mm
