argonraver/quadruped-robot-for-smart-agriculture-uofu/(list of files, cad)

Other CAD files:
Quadruped Robot for Smart Agriculture/CAD Files - ME EN 4000/Quadruped 8 DOF Solidworks CAD Files - ME EN 4000/2DOF Leg Solidworks STL Files/upper_leg_module_shell_cover.STL
Quadruped Robot for Smart Agriculture/CAD Files - ME EN 4000/Leg Parts/Easy_Print_Mod_1_upper_leg_module_shell_1.SLDPRT
Quadruped Robot for Smart Agriculture/CAD Files - ME EN 4000/Leg Parts/Easy_Print_Mod_1_upper_leg_module_cover_2.SLDPRT
Quadruped Robot for Smart Agriculture/Documentation/CAD Files/Meshes Documentation/Cover Male.3mf
Quadruped Robot for Smart Agriculture/Documentation/CAD Files/Meshes Documentation/Odrive Cap (outer).3mf
Quadruped Robot for Smart Agriculture/CAD Files - ME EN 4000/Leg Parts/Easy_Print_Mod_1_upper_leg_module_shell (1).SLDPRT
Quadruped Robot for Smart Agriculture/CAD Files - ME EN 4000/Leg Parts/Robo_Dog_Foot.STL
Quadruped Robot for Smart Agriculture/Documentation/CAD Files/Meshes Documentation/Odrive Rack (1).3mf
