argonraver/quadruped-robot-for-smart-agriculture-uofu/Quadruped Robot for Smart Agriculture/Documentation/Wiring Documentation/IMG_9371.JPG

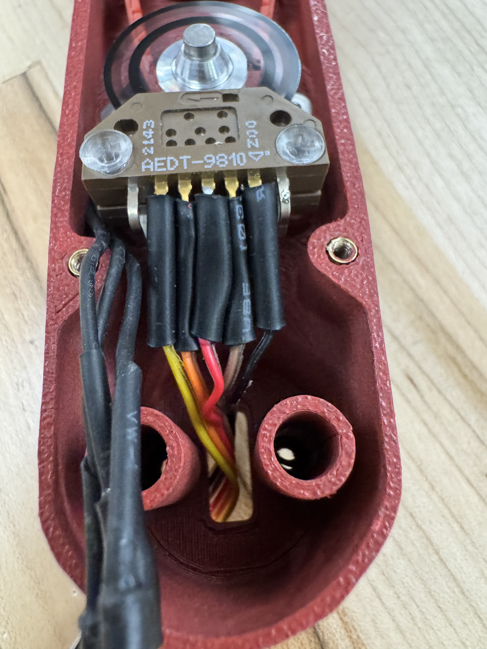
Quadruped Robot for Smart Agriculture/Documentation/Wiring Documentation/IMG_9371.JPG
