argonraver/quadruped-robot-for-smart-agriculture-uofu/Quadruped Robot for Smart Agriculture/Documentation/Wiring Documentation/IMG_9374.JPG

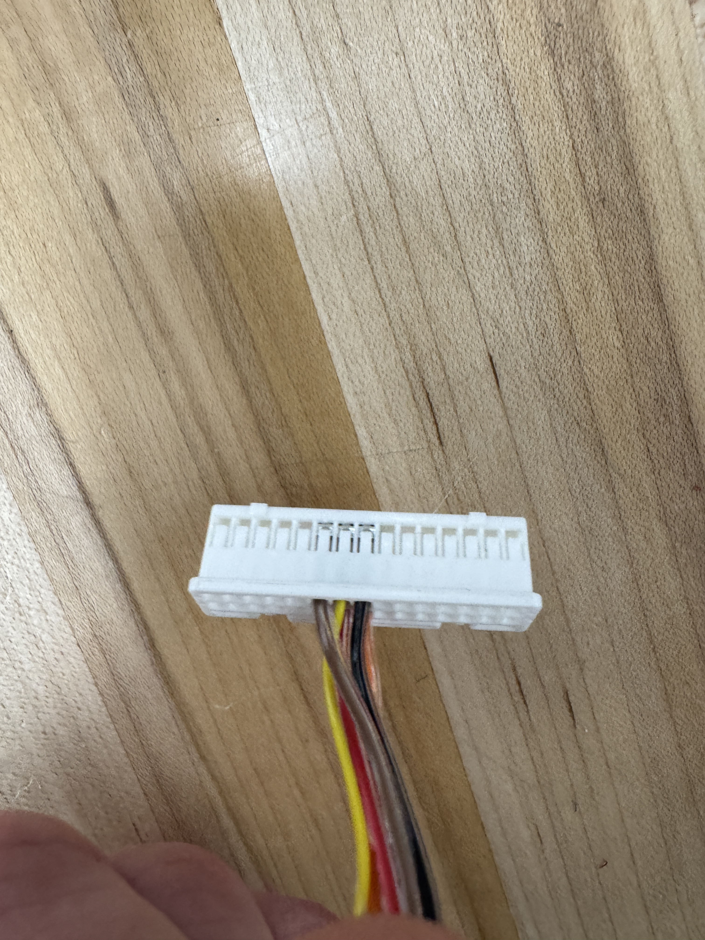
Quadruped Robot for Smart Agriculture/Documentation/Wiring Documentation/IMG_9374.JPG
