argonraver/quadruped-robot-for-smart-agriculture-uofu/Quadruped Robot for Smart Agriculture/Documentation/Wiring Documentation/IMG_9378(1).JPG

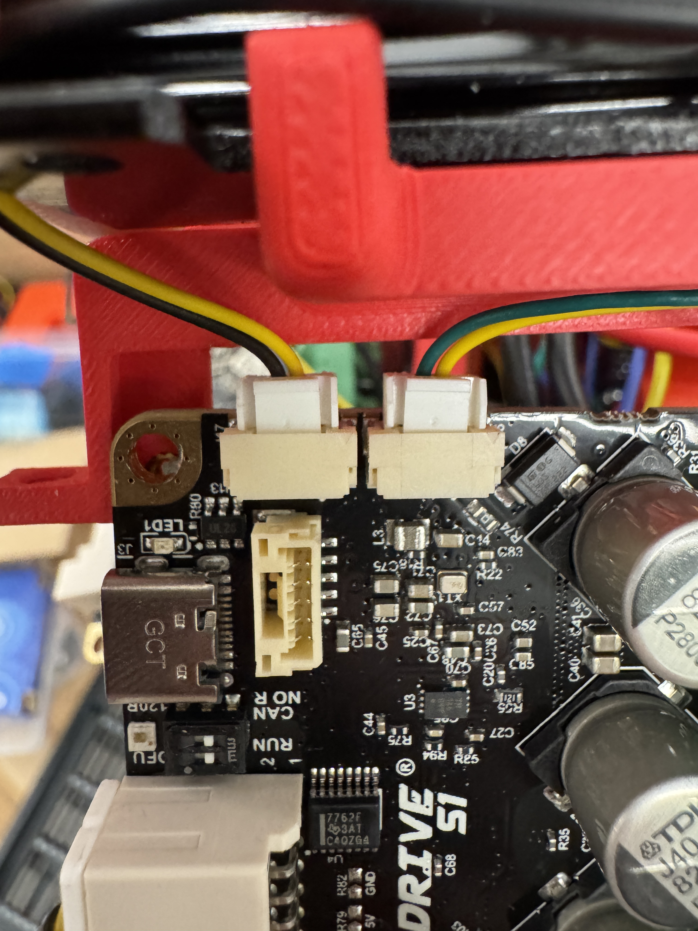
Quadruped Robot for Smart Agriculture/Documentation/Wiring Documentation/IMG_9378(1).JPG
