argonraver/quadruped-robot-for-smart-agriculture-uofu/Pictures and Videos/Fall/Test stand photos/Copy of Screenshot 2024-11-25 102034.png

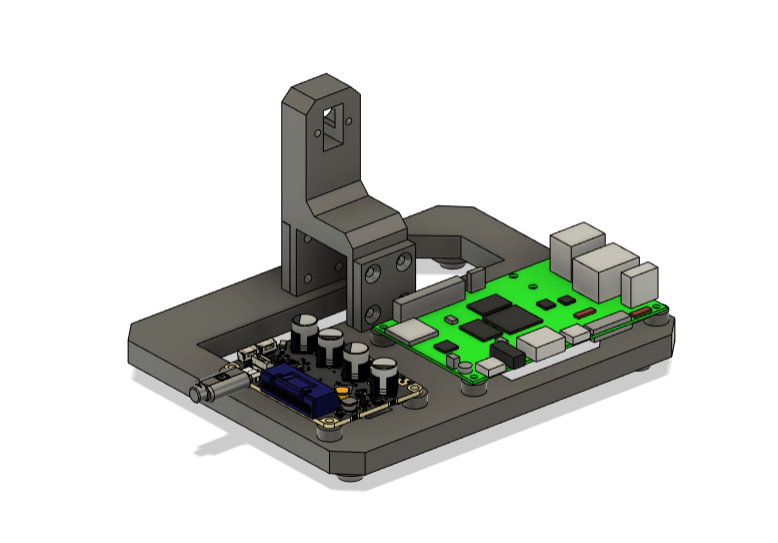
Pictures and Videos/Fall/Test stand photos/Copy of Screenshot 2024-11-25 102034.png
