argonraver/quadruped-robot-for-smart-agriculture-uofu/Quadruped Robot for Smart Agriculture/Fall Assignments/Sketches/Bolted Mounting Plate - Assignment 3 - ME EN 4000.pdf

I

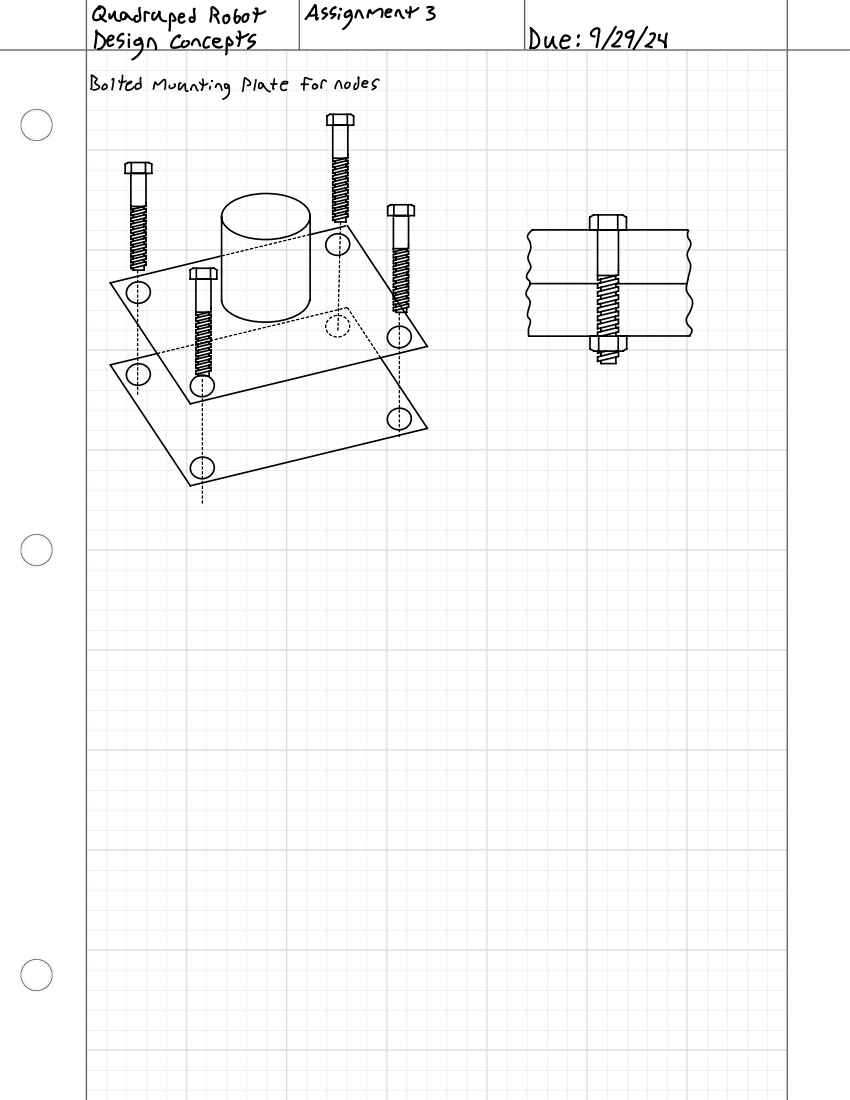
[picture p119: page 1]
Design concepts; Due 9 29 24

Quadruped Robot Assignment³
BoltedMounting Plate fornodes
