argonraver/quadruped-robot-for-smart-agriculture-uofu/Quadruped Robot for Smart Agriculture/Fall Assignments/Sketches/Rubber Rings - Assignment 3 - ME EN 4000.pdf

## Quadruped Robot Assignment

Design concepts | Due 9 29 24

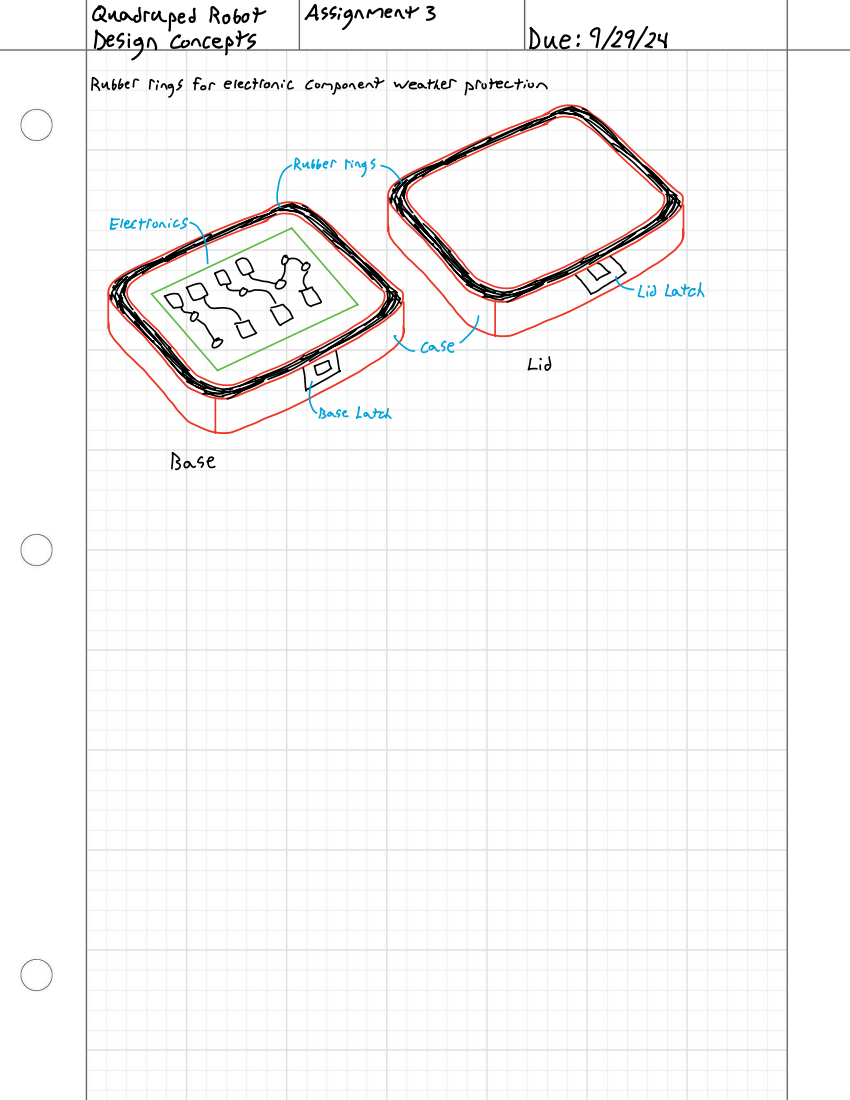
[picture p120: page 1]
iii; ii iiiiiiiiodiiie.ci.iiei iiii; Base

Rubberrings forelectroniccomponent weatherprotection
