argonraver/quadruped-robot-for-smart-agriculture-uofu/(list of files, drawings)

Other design files:
Quadruped Robot for Smart Agriculture/RobotElectronics Sketch.fzz
