argonraver/quadruped-robot-for-smart-agriculture-uofu/(commit log)

2025-04-24 Upload ros_odrive/odrive_ros2_control/CMakeLists.txt
2025-04-24 Upload ros_odrive/odrive_ros2_control/package.xml
2025-04-24 Upload ros_odrive/odrive_ros2_control/README.md
2025-04-24 Upload ros_odrive/odrive_ros2_control/odrive_hardware_interface.xml
2025-04-24 Upload ros_odrive/odrive_ros2_control/src/odrive_hardware_interface.cpp
2025-04-24 Upload ros_odrive/odrive_base/.DS_Store
2025-04-24 Upload ros_odrive/odrive_base/include/odrive_enums.h
2025-04-24 Upload ros_odrive/odrive_base/include/can_simple_messages.hpp
2025-04-24 Upload ros_odrive/odrive_base/include/can_helpers.hpp
2025-04-24 Upload ros_odrive/odrive_base/include/socket_can.hpp
2025-04-24 Upload ros_odrive/odrive_base/include/epoll_event_loop.hpp
2025-04-24 Upload ros_odrive/odrive_base/src/epoll_event_loop.cpp
2025-04-24 Upload ros_odrive/odrive_base/src/socket_can.cpp
2025-04-24 Upload ros_odrive/odrive_node/CMakeLists.txt
2025-04-24 Upload ros_odrive/odrive_node/.DS_Store
2025-04-24 Upload ros_odrive/odrive_node/package.xml
2025-04-24 Upload ros_odrive/odrive_node/README.md
2025-04-24 Upload ros_odrive/odrive_node/msg/ControllerStatus.msg
2025-04-24 Upload ros_odrive/odrive_node/msg/ControlMessage.msg
2025-04-24 Upload ros_odrive/odrive_node/msg/ODriveStatus.msg
2025-04-24 Upload ros_odrive/odrive_node/launch/example_launch.yaml
2025-04-24 Upload ros_odrive/odrive_node/include/odrive_can_node.hpp
2025-04-24 Upload ros_odrive/odrive_node/include/byte_swap.hpp
2025-04-24 Upload ros_odrive/odrive_node/srv/AxisState.srv
2025-04-24 Upload ros_odrive/odrive_node/src/odrive_can_node.cpp
2025-04-24 Upload ros_odrive/odrive_node/src/main.cpp
2025-04-24 Upload ros_odrive/odrive_botwheel_explorer/CMakeLists.txt
2025-04-24 Upload ros_odrive/odrive_botwheel_explorer/.DS_Store
2025-04-24 Upload ros_odrive/odrive_botwheel_explorer/package.xml
2025-04-24 Upload ros_odrive/odrive_botwheel_explorer/README.md
2025-04-24 Upload ros_odrive/odrive_botwheel_explorer/structure.png
2025-04-24 Upload ros_odrive/odrive_botwheel_explorer/config/diffbot_controllers.yaml
    [diffbot_controllers.yaml]
2025-04-24 Upload ros_odrive/odrive_botwheel_explorer/launch/botwheel_explorer.launch.py
2025-04-24 Upload ros_odrive/odrive_botwheel_explorer/description/urdf/diffbot.urdf.xacro
    [diffbot.urdf.xacro]
2025-04-24 Upload ros_odrive/odrive_botwheel_explorer/description/urdf/diffbot_description.urdf.xacro
    [diffbot_description.urdf.xacro]
2025-04-24 Upload ros_odrive/odrive_botwheel_explorer/description/urdf/diffbot.ros2_control.xacro
    [diffbot.ros2_control.xacro]
2025-04-24 Upload Quadruped Robot for Smart Agriculture/Robot Kinematics - ME EN 4000.pdf
2025-04-24 Upload Quadruped Robot for Smart Agriculture/RobotElectronics Sketch.fzz
    [RobotElectronics Sketch.fzz]
2025-04-24 Upload Quadruped Robot for Smart Agriculture/BOM.xlsx
    [BOM.xlsx]
2025-04-24 Upload Quadruped Robot for Smart Agriculture/Documentation/ODrive Arrangement.jpg
2025-04-24 Upload Quadruped Robot for Smart Agriculture/Documentation/Leg Documentation.docx
2025-04-24 Upload Quadruped Robot for Smart Agriculture/Documentation/Wiring Documentation/Wiring Guide.docx
2025-04-24 Upload Quadruped Robot for Smart Agriculture/Documentation/Wiring Documentation/IMG_9379.JPG
2025-04-24 Upload Quadruped Robot for Smart Agriculture/Documentation/Wiring Documentation/IMG_9378.JPG
2025-04-24 Upload Quadruped Robot for Smart Agriculture/Documentation/Wiring Documentation/IMG_9378(1).JPG
2025-04-24 Upload Quadruped Robot for Smart Agriculture/Documentation/Wiring Documentation/IMG_9377(1).JPG
2025-04-24 Upload Quadruped Robot for Smart Agriculture/Documentation/Wiring Documentation/IMG_9371.JPG
2025-04-24 Upload Quadruped Robot for Smart Agriculture/Documentation/Wiring Documentation/IMG_9375.JPG
2025-04-24 Upload Quadruped Robot for Smart Agriculture/Documentation/Wiring Documentation/IMG_9374.JPG
2025-04-24 Upload Quadruped Robot for Smart Agriculture/Documentation/Wiring Documentation/IMG_9376.JPG
2025-04-24 Upload Quadruped Robot for Smart Agriculture/Documentation/Wiring Documentation/IMG_9377.JPG
2025-04-24 Upload Quadruped Robot for Smart Agriculture/Documentation/CAD Files/Quadruped Body v18.step
2025-04-24 Upload Quadruped Robot for Smart Agriculture/Documentation/CAD Files/Quadruped Body v18.f3z
2025-04-24 Upload Quadruped Robot for Smart Agriculture/Documentation/CAD Files/Meshes Documentation/Fan_IMU Mount.3mf
    [Fan_IMU Mount.3mf]
2025-04-24 Upload Quadruped Robot for Smart Agriculture/Documentation/CAD Files/Meshes Documentation/Odrive Cap (outer).3mf
    [Odrive Cap (outer).3mf]
2025-04-24 Upload Quadruped Robot for Smart Agriculture/Documentation/CAD Files/Meshes Documentation/Odrive Cap.3mf
    [Odrive Cap.3mf]
2025-04-24 Upload Quadruped Robot for Smart Agriculture/Documentation/CAD Files/Meshes Documentation/Body Half.3mf
    [Body Half.3mf]
2025-04-24 Upload Quadruped Robot for Smart Agriculture/Documentation/CAD Files/Meshes Documentation/Cover Bracket.3mf
    [Cover Bracket.3mf]
2025-04-24 Upload Quadruped Robot for Smart Agriculture/Documentation/CAD Files/Meshes Documentation/body_structure_side v1.3mf
    [body_structure_side v1.3mf]
2025-04-24 Upload Quadruped Robot for Smart Agriculture/Documentation/CAD Files/Meshes Documentation/Body Podium Base.3mf
    [Body Podium Base.3mf]
2025-04-24 Upload Quadruped Robot for Smart Agriculture/Documentation/CAD Files/Meshes Documentation/Odrive Rack (1).3mf
    [Odrive Rack (1).3mf]
2025-04-24 Upload Quadruped Robot for Smart Agriculture/Documentation/CAD Files/Meshes Documentation/Odrive Rack.3mf
    [Odrive Rack.3mf]
2025-04-24 Upload Quadruped Robot for Smart Agriculture/Documentation/CAD Files/Meshes Documentation/Cover Male.3mf
    [Cover Male.3mf]
2025-04-24 Upload Quadruped Robot for Smart Agriculture/Documentation/CAD Files/Meshes Documentation/Handle.3mf
    [Handle.3mf]
2025-04-24 Upload Quadruped Robot for Smart Agriculture/Documentation/CAD Files/Meshes Documentation/Cover Female.3mf
    [Cover Female.3mf]
2025-04-24 Upload Quadruped Robot for Smart Agriculture/Documentation/CAD Files/Meshes Documentation/Power and Pi Rack.3mf
    [Power and Pi Rack.3mf]
2025-04-24 Upload Quadruped Robot for Smart Agriculture/Documentation/CAD Files/Meshes Documentation/body_structure_front v1.3mf
    [body_structure_front v1.3mf]
2025-04-24 Upload Quadruped Robot for Smart Agriculture/Documentation/CAD Files/Meshes Documentation/Body Podium.3mf
    [Body Podium.3mf]
2025-04-24 Upload Quadruped Robot for Smart Agriculture/Documentation/CAD Files/Meshes Documentation/Odrive Cap (inner).3mf
    [Odrive Cap (inner).3mf]
2025-04-24 Upload Quadruped Robot for Smart Agriculture/Documentation/CAD Files/Meshes Documentation/Quadruped Body_body_structure_front v1_no_hole v1 (1).3mf
    [Quadruped Body_body_structure_front v1_no_hole v1 (1).3mf]
2025-04-24 Upload Quadruped Robot for Smart Agriculture/Documentation/CAD Files/Meshes Documentation/OPi Cap.3mf
    [OPi Cap.3mf]
2025-04-24 Upload Quadruped Robot for Smart Agriculture/Spring Assignments/Project Milestones Document.docx Assignment 1 SIGNED.pdf
2025-04-24 Upload Quadruped Robot for Smart Agriculture/Spring Assignments/ME EN 4010 Midterm Report team 12.docx
2025-04-24 Upload Quadruped Robot for Smart Agriculture/Spring Assignments/GANTT CHART_.xlsx
    [GANTT CHART_.xlsx]
2025-04-24 Upload Quadruped Robot for Smart Agriculture/Spring Assignments/Project Milestones Document.docx
2025-04-24 Upload Quadruped Robot for Smart Agriculture/Spring Assignments/Design Day Poster.pptx
2025-04-24 Upload Quadruped Robot for Smart Agriculture/Spring Assignments/Design Review 1 Spring.pptx
2025-04-24 Upload Quadruped Robot for Smart Agriculture/Spring Assignments/GANTT CHART (Ben_s Edit).xlsx
    [GANTT CHART (Ben_s Edit).xlsx]
2025-04-24 Upload Quadruped Robot for Smart Agriculture/Spring Assignments/GANTT CHART February to end.xlsx
    [GANTT CHART February to end.xlsx]
2025-04-24 Upload Quadruped Robot for Smart Agriculture/Spring Assignments/Final Presentation Notes.docx
2025-04-24 Upload Quadruped Robot for Smart Agriculture/Spring Assignments/A)ME EN 4010 FINAL Report team 12.docx
2025-04-24 Upload Quadruped Robot for Smart Agriculture/Spring Assignments/Design Review 2 Spring.pptx
2025-04-24 Upload Quadruped Robot for Smart Agriculture/Code - ME EN 4000/Kalman Filtering cpp/kalmanFiltering
2025-04-24 Upload Quadruped Robot for Smart Agriculture/Code - ME EN 4000/Kalman Filtering cpp/.DS_Store
2025-04-24 Upload Quadruped Robot for Smart Agriculture/Code - ME EN 4000/Kalman Filtering cpp/README.md
2025-04-24 Upload Quadruped Robot for Smart Agriculture/Code - ME EN 4000/Kalman Filtering cpp/kalmanFiltering.cpp
2025-04-24 Upload Quadruped Robot for Smart Agriculture/Code - ME EN 4000/Kalman Filtering cpp/kalmanFiltering.dSYM/Contents/Info.plist
2025-04-24 Upload Quadruped Robot for Smart Agriculture/Code - ME EN 4000/Kalman Filtering cpp/kalmanFiltering.dSYM/Contents/Resources/Relocations/aarch64/kalmanFiltering.yml
2025-04-24 Upload Quadruped Robot for Smart Agriculture/Code - ME EN 4000/Kalman Filtering cpp/kalmanFiltering.dSYM/Contents/Resources/DWARF/kalmanFiltering
2025-04-24 Upload Quadruped Robot for Smart Agriculture/Code - ME EN 4000/basewalk_ws/calibrate_all.sh
2025-04-24 Upload Quadruped Robot for Smart Agriculture/Code - ME EN 4000/basewalk_ws/src/ros_odrive/odrive_ros2_control/CMakeLists.txt
2025-04-24 Upload Quadruped Robot for Smart Agriculture/Code - ME EN 4000/basewalk_ws/src/ros_odrive/odrive_ros2_control/package.xml
2025-04-24 Upload Quadruped Robot for Smart Agriculture/Code - ME EN 4000/basewalk_ws/src/ros_odrive/odrive_ros2_control/README.md
2025-04-24 Upload Quadruped Robot for Smart Agriculture/Code - ME EN 4000/basewalk_ws/src/ros_odrive/odrive_ros2_control/odrive_hardware_interface.xml
2025-04-24 Upload Quadruped Robot for Smart Agriculture/Code - ME EN 4000/basewalk_ws/src/ros_odrive/odrive_ros2_control/src/odrive_hardware_interface.cpp
2025-04-24 Upload Quadruped Robot for Smart Agriculture/Code - ME EN 4000/basewalk_ws/src/ros_odrive/odrive_base/include/odrive_enums.h
2025-04-24 Upload Quadruped Robot for Smart Agriculture/Code - ME EN 4000/basewalk_ws/src/ros_odrive/odrive_base/include/can_simple_messages.hpp
2025-04-24 Upload Quadruped Robot for Smart Agriculture/Code - ME EN 4000/basewalk_ws/src/ros_odrive/odrive_base/include/can_helpers.hpp
2025-04-24 Upload Quadruped Robot for Smart Agriculture/Code - ME EN 4000/basewalk_ws/src/ros_odrive/odrive_base/include/socket_can.hpp
2025-04-24 Upload Quadruped Robot for Smart Agriculture/Code - ME EN 4000/basewalk_ws/src/ros_odrive/odrive_base/include/epoll_event_loop.hpp
2025-04-24 Upload Quadruped Robot for Smart Agriculture/Code - ME EN 4000/basewalk_ws/src/ros_odrive/odrive_base/src/epoll_event_loop.cpp
2025-04-24 Upload Quadruped Robot for Smart Agriculture/Code - ME EN 4000/basewalk_ws/src/ros_odrive/odrive_base/src/socket_can.cpp
2025-04-24 Upload Quadruped Robot for Smart Agriculture/Code - ME EN 4000/basewalk_ws/src/ros_odrive/odrive_node/CMakeLists.txt
2025-04-24 Upload Quadruped Robot for Smart Agriculture/Code - ME EN 4000/basewalk_ws/src/ros_odrive/odrive_node/package.xml
2025-04-24 Upload Quadruped Robot for Smart Agriculture/Code - ME EN 4000/basewalk_ws/src/ros_odrive/odrive_node/README.md
2025-04-24 Upload Quadruped Robot for Smart Agriculture/Code - ME EN 4000/basewalk_ws/src/ros_odrive/odrive_node/msg/ControllerStatus.msg
2025-04-24 Upload Quadruped Robot for Smart Agriculture/Code - ME EN 4000/basewalk_ws/src/ros_odrive/odrive_node/msg/ControlMessage.msg
2025-04-24 Upload Quadruped Robot for Smart Agriculture/Code - ME EN 4000/basewalk_ws/src/ros_odrive/odrive_node/msg/ODriveStatus.msg
2025-04-24 Upload Quadruped Robot for Smart Agriculture/Code - ME EN 4000/basewalk_ws/src/ros_odrive/odrive_node/launch/example_launch.yaml
2025-04-24 Upload Quadruped Robot for Smart Agriculture/Code - ME EN 4000/basewalk_ws/src/ros_odrive/odrive_node/include/odrive_can_node.hpp
2025-04-24 Upload Quadruped Robot for Smart Agriculture/Code - ME EN 4000/basewalk_ws/src/ros_odrive/odrive_node/include/byte_swap.hpp
2025-04-24 Upload Quadruped Robot for Smart Agriculture/Code - ME EN 4000/basewalk_ws/src/ros_odrive/odrive_node/srv/AxisState.srv
2025-04-24 Upload Quadruped Robot for Smart Agriculture/Code - ME EN 4000/basewalk_ws/src/ros_odrive/odrive_node/src/odrive_can_node.cpp
2025-04-24 Upload Quadruped Robot for Smart Agriculture/Code - ME EN 4000/basewalk_ws/src/ros_odrive/odrive_node/src/main.cpp
2025-04-24 Upload Quadruped Robot for Smart Agriculture/Code - ME EN 4000/basewalk_ws/src/ros_odrive/odrive_botwheel_explorer/CMakeLists.txt
2025-04-24 Upload Quadruped Robot for Smart Agriculture/Code - ME EN 4000/basewalk_ws/src/ros_odrive/odrive_botwheel_explorer/package.xml
2025-04-24 Upload Quadruped Robot for Smart Agriculture/Code - ME EN 4000/basewalk_ws/src/ros_odrive/odrive_botwheel_explorer/README.md
2025-04-24 Upload Quadruped Robot for Smart Agriculture/Code - ME EN 4000/basewalk_ws/src/ros_odrive/odrive_botwheel_explorer/structure.png
2025-04-24 Upload Quadruped Robot for Smart Agriculture/Code - ME EN 4000/basewalk_ws/src/ros_odrive/odrive_botwheel_explorer/config/diffbot_controllers.yaml
    [diffbot_controllers.yaml]
2025-04-24 Upload Quadruped Robot for Smart Agriculture/Code - ME EN 4000/basewalk_ws/src/ros_odrive/odrive_botwheel_explorer/launch/botwheel_explorer.launch.py
2025-04-24 Upload Quadruped Robot for Smart Agriculture/Code - ME EN 4000/basewalk_ws/src/ros_odrive/odrive_botwheel_explorer/description/urdf/diffbot.urdf.xacro
    [diffbot.urdf.xacro]
2025-04-24 Upload Quadruped Robot for Smart Agriculture/Code - ME EN 4000/basewalk_ws/src/ros_odrive/odrive_botwheel_explorer/description/urdf/diffbot_description.urdf.xacro
    [diffbot_description.urdf.xacro]
2025-04-24 Upload Quadruped Robot for Smart Agriculture/Code - ME EN 4000/basewalk_ws/src/ros_odrive/odrive_botwheel_explorer/description/urdf/diffbot.ros2_control.xacro
    [diffbot.ros2_control.xacro]
2025-04-24 Upload Quadruped Robot for Smart Agriculture/Code - ME EN 4000/basewalk_ws/src/cpp_controller_node/imu_reader/__init__.py
2025-04-24 Upload Quadruped Robot for Smart Agriculture/Code - ME EN 4000/basewalk_ws/src/cpp_controller_node/imu_reader/module_to_import.py
2025-04-24 Upload Quadruped Robot for Smart Agriculture/Code - ME EN 4000/basewalk_ws/src/cpp_controller_node/imu_reader/.vscode/settings.json
2025-04-24 Upload Quadruped Robot for Smart Agriculture/Code - ME EN 4000/basewalk_ws/src/cpp_controller_node/imu_reader/.vscode/c_cpp_properties.json
2025-04-24 Upload Quadruped Robot for Smart Agriculture/Code - ME EN 4000/basewalk_ws/src/cpp_controller_node/scripts/imureader.py
2025-04-24 Upload Quadruped Robot for Smart Agriculture/Code - ME EN 4000/basewalk_ws/src/cpp_controller_node/src/imufilterservice.cpp
2025-04-24 Upload Quadruped Robot for Smart Agriculture/Code - ME EN 4000/basewalk_ws/src/cpp_controller_node/src/IMU_node_cli.cpp
2025-04-24 Upload Quadruped Robot for Smart Agriculture/Code - ME EN 4000/basewalk_ws/src/odrive_controller/LICENSE
2025-04-24 Upload Quadruped Robot for Smart Agriculture/Code - ME EN 4000/basewalk_ws/src/odrive_controller/package.xml
2025-04-24 Upload Quadruped Robot for Smart Agriculture/Code - ME EN 4000/basewalk_ws/src/odrive_controller/setup.py
2025-04-24 Upload Quadruped Robot for Smart Agriculture/Code - ME EN 4000/basewalk_ws/src/odrive_controller/setup.cfg
2025-04-24 Upload Quadruped Robot for Smart Agriculture/Code - ME EN 4000/basewalk_ws/src/odrive_controller/test/test_flake8.py
2025-04-24 Upload Quadruped Robot for Smart Agriculture/Code - ME EN 4000/basewalk_ws/src/odrive_controller/test/test_copyright.py
2025-04-24 Upload Quadruped Robot for Smart Agriculture/Code - ME EN 4000/basewalk_ws/src/odrive_controller/test/test_pep257.py
2025-04-24 Upload Quadruped Robot for Smart Agriculture/Code - ME EN 4000/basewalk_ws/src/odrive_controller/odrive_controller/odrive_controller.py
2025-04-24 Upload Quadruped Robot for Smart Agriculture/Code - ME EN 4000/basewalk_ws/src/odrive_controller/odrive_controller/__init__.py
2025-04-24 Upload Quadruped Robot for Smart Agriculture/Code - ME EN 4000/basewalk_ws/src/odrive_controller/resource/odrive_controller
2025-04-24 Upload Quadruped Robot for Smart Agriculture/Code - ME EN 4000/basewalk_ws/src/control_interfaces/msg/JointAngles.msg
2025-04-24 Upload Quadruped Robot for Smart Agriculture/Code - ME EN 4000/basewalk_ws/src/control_interfaces/msg/Imuinterface.msg
2025-04-24 Upload Quadruped Robot for Smart Agriculture/Code - ME EN 4000/basewalk_ws/src/control_interfaces/msg/Filteredimuinterface.msg
2025-04-24 Upload Quadruped Robot for Smart Agriculture/Code - ME EN 4000/basewalk_ws/src/control_interfaces/srv/Imufilteredinterface.srv
2025-04-24 Upload Quadruped Robot for Smart Agriculture/Code - ME EN 4000/basewalk_ws/src/control_interfaces/srv/Imufilterinterface.srv
2025-04-24 Upload Quadruped Robot for Smart Agriculture/Fall Assignments/OLD GANTT CHART.xlsx
    [OLD GANTT CHART.xlsx]
2025-04-24 Upload Quadruped Robot for Smart Agriculture/Fall Assignments/Sketches/Dual Purpose Lid Case.jpg
2025-04-24 Upload Quadruped Robot for Smart Agriculture/Fall Assignments/Sketches/Charging Case.jpg
2025-04-24 Upload Quadruped Robot for Smart Agriculture/Fall Assignments/Sketches/Bolted Mounting Plate - Assignment 3 - ME EN 4000.pdf
2025-04-24 Upload Quadruped Robot for Smart Agriculture/Fall Assignments/Fall slides/Midterm Review 1 Spring Slides.pptx
2025-04-24 Upload Quadruped Robot for Smart Agriculture/Fall Assignments/Fall slides/Final Presentation Assignments_.xlsx
    [Final Presentation Assignments_.xlsx]
2025-04-24 Upload Quadruped Robot for Smart Agriculture/CAD Files - ME EN 4000/.DS_Store
2025-04-24 Upload Quadruped Robot for Smart Agriculture/CAD Files - ME EN 4000/Quadruped 8 DOF Solidworks CAD Files - ME EN 4000/quadruped_8dof_v2.zip
2025-04-24 Upload Quadruped Robot for Smart Agriculture/CAD Files - ME EN 4000/Quadruped 8 DOF Solidworks CAD Files - ME EN 4000/2DOF Leg Solidworks STL Files/hip_module_shell_base.STL
2025-04-24 Upload Quadruped Robot for Smart Agriculture/CAD Files - ME EN 4000/Quadruped 8 DOF Solidworks CAD Files - ME EN 4000/2DOF Leg Solidworks STL Files/upper_leg_module_shell_cover.STL
    [upper_leg_module_shell_cover.STL]
2025-04-24 Upload Quadruped Robot for Smart Agriculture/CAD Files - ME EN 4000/Quadruped 8 DOF Solidworks CAD Files - ME EN 4000/2DOF Leg Solidworks STL Files/lower_leg_v3.STL
    [lower_leg_v3.STL]
2025-04-24 Upload Quadruped Robot for Smart Agriculture/CAD Files - ME EN 4000/Quadruped 8 DOF Solidworks CAD Files - ME EN 4000/2DOF Leg Solidworks STL Files/upper_leg_module_shell_base.STL
2025-04-24 Upload Quadruped Robot for Smart Agriculture/CAD Files - ME EN 4000/Quadruped 8 DOF Solidworks CAD Files - ME EN 4000/2DOF Leg Solidworks STL Files/hip_module_shell_cover.STL
    [hip_module_shell_cover.STL]
2025-04-24 Upload Quadruped Robot for Smart Agriculture/CAD Files - ME EN 4000/Leg Parts/Easy_Print_Mod_1_upper_leg_module_cover_2.SLDPRT
    [Easy_Print_Mod_1_upper_leg_module_cover_2.SLDPRT]
2025-04-24 Upload Quadruped Robot for Smart Agriculture/CAD Files - ME EN 4000/Leg Parts/Robo_Dog_Foot.STL
    [Robo_Dog_Foot.STL]
2025-04-24 Upload Quadruped Robot for Smart Agriculture/CAD Files - ME EN 4000/Leg Parts/Easy_Print_Mod_1_upper_leg_module_shell (1).SLDPRT
    [Easy_Print_Mod_1_upper_leg_module_shell (1).SLDPRT]
2025-04-24 Upload Quadruped Robot for Smart Agriculture/CAD Files - ME EN 4000/Leg Parts/Easy_Print_Mod_1_upper_leg_module_shell_1.SLDPRT
    [Easy_Print_Mod_1_upper_leg_module_shell_1.SLDPRT]
2025-04-24 Upload Quadruped Robot for Smart Agriculture/CAD Files - ME EN 4000/Leg Parts/Easy_Print_Mod_1_lower_leg_solid (1).SLDPRT
    [Easy_Print_Mod_1_lower_leg_solid (1).SLDPRT]
2025-04-24 Upload Quadruped Robot for Smart Agriculture/CAD Files - ME EN 4000/Leg Parts/Easy_Print_Mod_1_upper_leg_module_cover_1.SLDPRT
    [Easy_Print_Mod_1_upper_leg_module_cover_1.SLDPRT]
2025-04-24 Upload Quadruped Robot for Smart Agriculture/CAD Files - ME EN 4000/Leg Parts/Robo_Dog_Foot.SLDPRT
    [Robo_Dog_Foot.SLDPRT]
2025-04-24 Upload Quadruped Robot for Smart Agriculture/CAD Files - ME EN 4000/Leg Parts/Easy_Print_Mod_1_upper_leg_module_shell_2.SLDPRT
    [Easy_Print_Mod_1_upper_leg_module_shell_2.SLDPRT]
