argonraver/quadruped-robot-for-smart-agriculture-uofu/Pictures and Videos/Fall/Test stand photos/IMG_5314.jpg

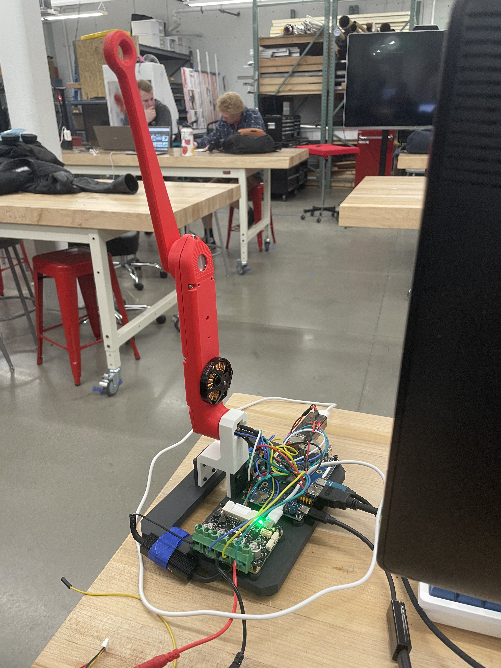
Pictures and Videos/Fall/Test stand photos/IMG_5314.jpg
