argonraver/quadruped-robot-for-smart-agriculture-uofu/Pictures and Videos/Fall/Test stand photos/IMG_5313.jpg

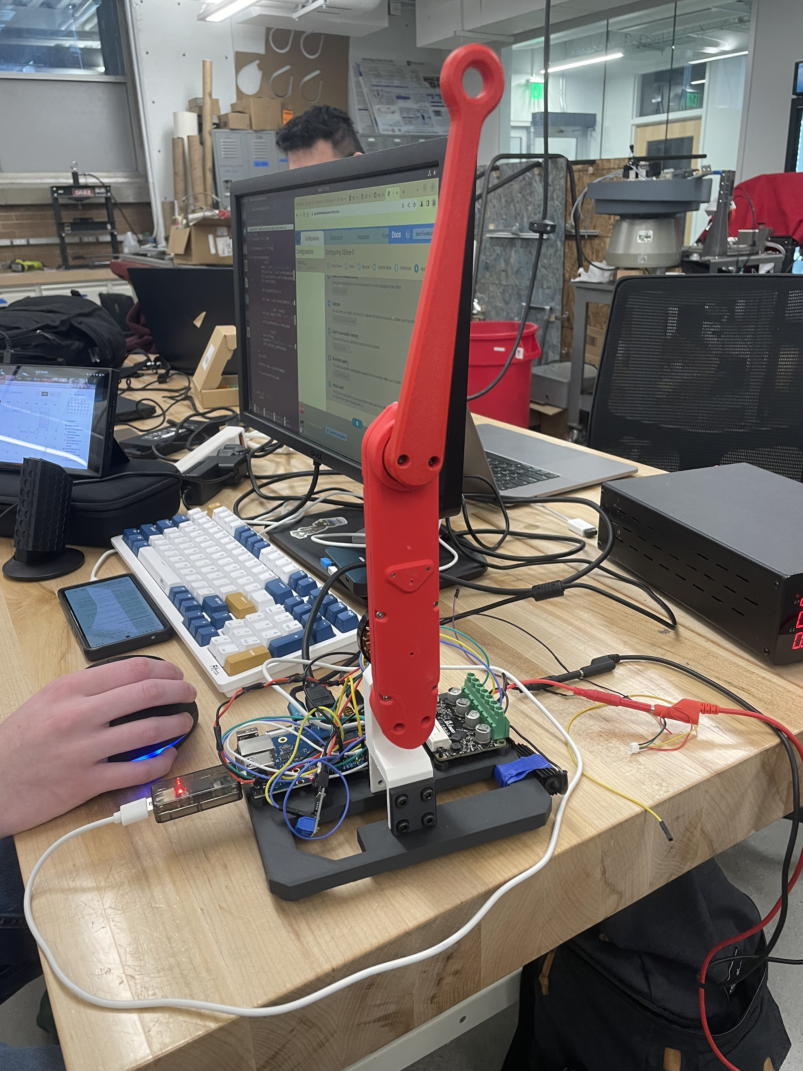
Pictures and Videos/Fall/Test stand photos/IMG_5313.jpg
