argonraver/quadruped-robot-for-smart-agriculture-uofu/Pictures and Videos/Fall/Test stand photos/IMG_9156.JPG

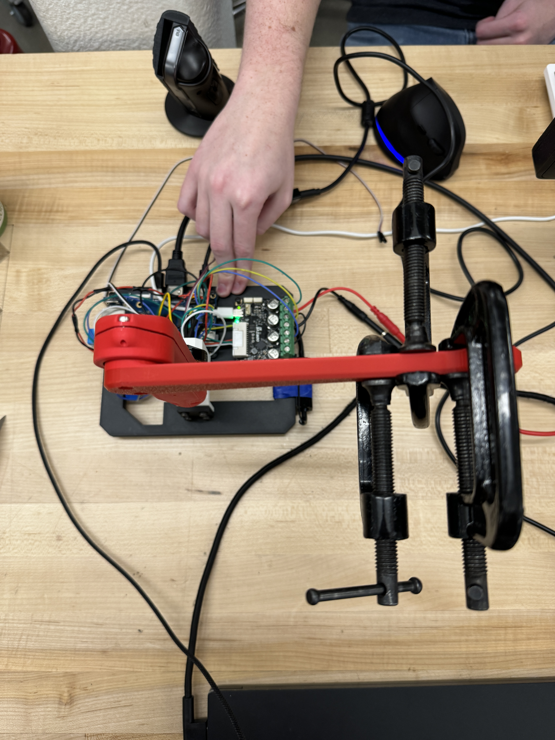
Pictures and Videos/Fall/Test stand photos/IMG_9156.JPG
